Sciddie/voice-satelite/case/3mf/voicesat-weiss-diffusor-schablone.3mf

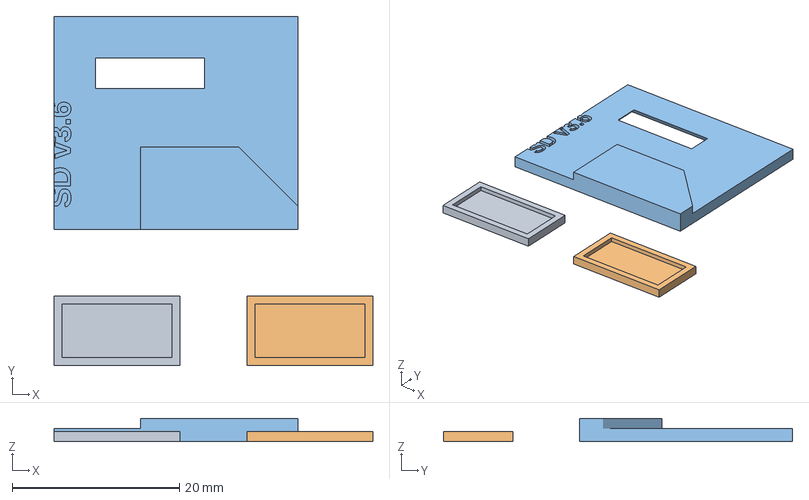
[picture p7: CAD file, 2026-10-12]
case/3mf/voicesat-weiss-diffusor-schablone.3mf
38.2 x 41.8 x 2.80 mm
led_diffuser_WHITE_1
led_diffuser_WHITE_2
sd_schablone_v36_WHITE
