Sciddie/voice-satelite/case/stl/lid.stl

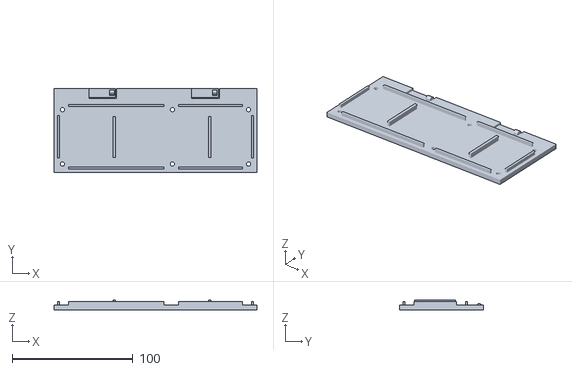
[picture p8: CAD file, 2026-10-12]
case/stl/lid.stl
168.0 x 69.5 x 8.00
