Sciddie/voice-satelite/case/3mf/voicesat-case-v3.7-black.3mf

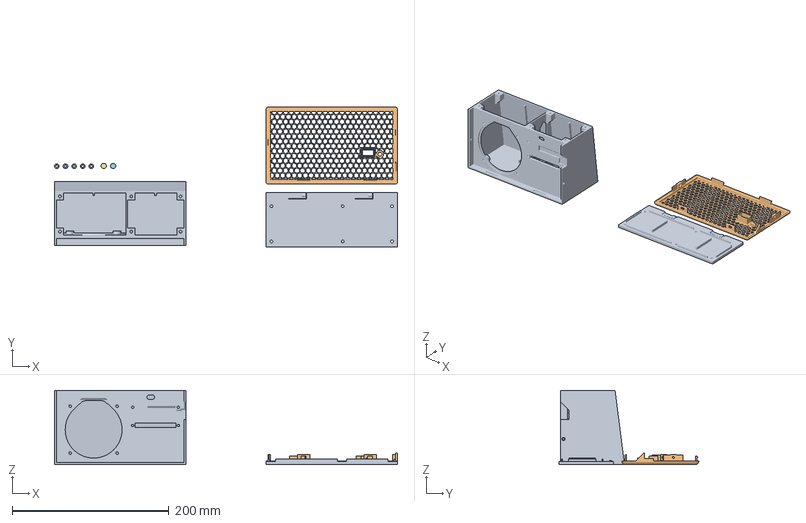
[picture p9: CAD file, 2026-10-12]
case/3mf/voicesat-case-v3.7-black.3mf
438.0 x 178.5 x 94.5 mm
tube_spacer_1
tube_spacer_2
tube_spacer_3
tube_spacer_4
tube_spacer_5
plunger_1
plunger_2
lid
grille
