Sciddie/voice-satelite/case/stl/body.stl

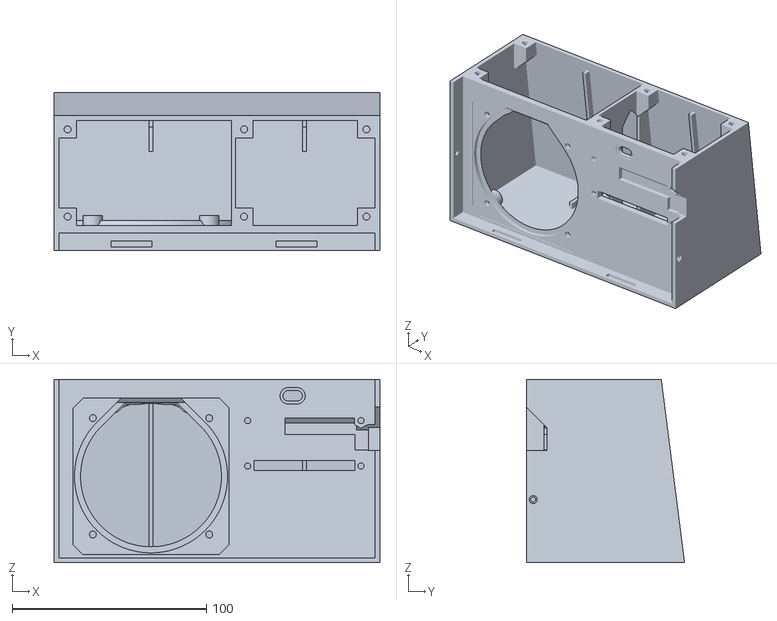
[picture p10: CAD file, 2026-10-12]
case/stl/body.stl
168.0 x 81.5 x 94.5
