Sciddie/voice-satelite/case/3mf/voicesat-case-v3.7-white.3mf

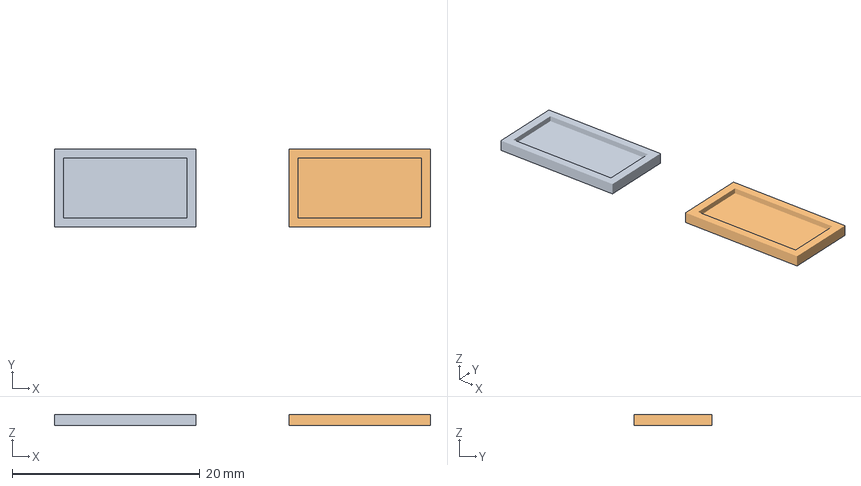
[picture p11: CAD file, 2026-10-12]
case/3mf/voicesat-case-v3.7-white.3mf
40.1 x 8.30 x 1.20 mm
led_diffuser_WHITE_1
led_diffuser_WHITE_2
