Sciddie/voice-satelite/case/stl/diffuser.stl

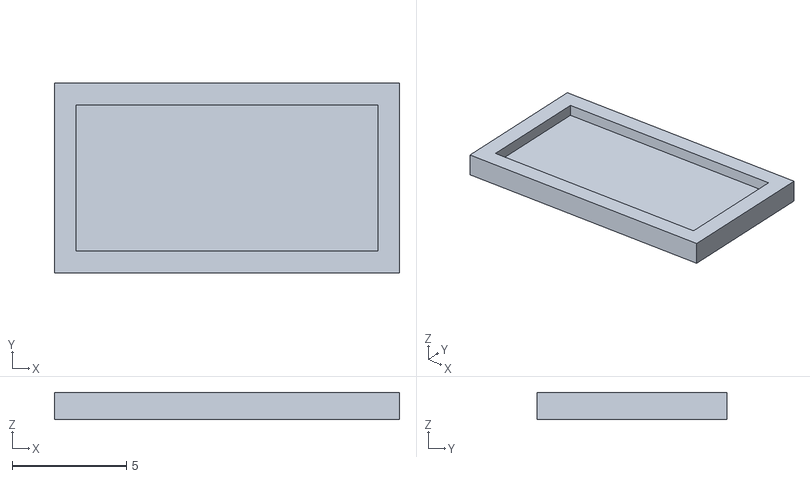
[picture p12: CAD file, 2026-10-12]
case/stl/diffuser.stl
15.1 x 8.30 x 1.20
