Sciddie/voice-satelite/case/3mf/voicesat-case-v3.7-black-plate2.3mf

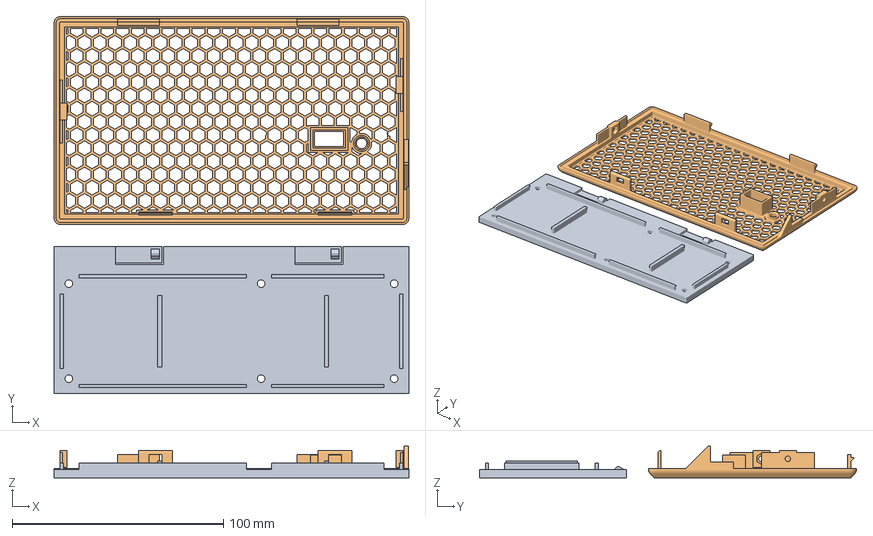
[picture p13: CAD file, 2026-10-12]
case/3mf/voicesat-case-v3.7-black-plate2.3mf
168.0 x 178.5 x 15.0 mm
lid
grille
