Sciddie/voice-satelite/case/stl/grille.stl

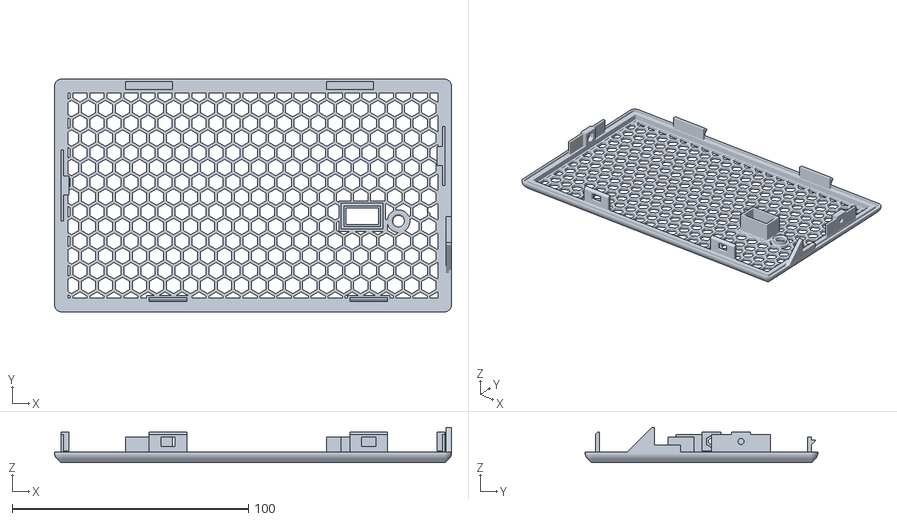
[picture p14: CAD file, 2026-10-12]
case/stl/grille.stl
168.0 x 98.5 x 15.0
