Sciddie/voice-satelite/case/stl/plunger.stl

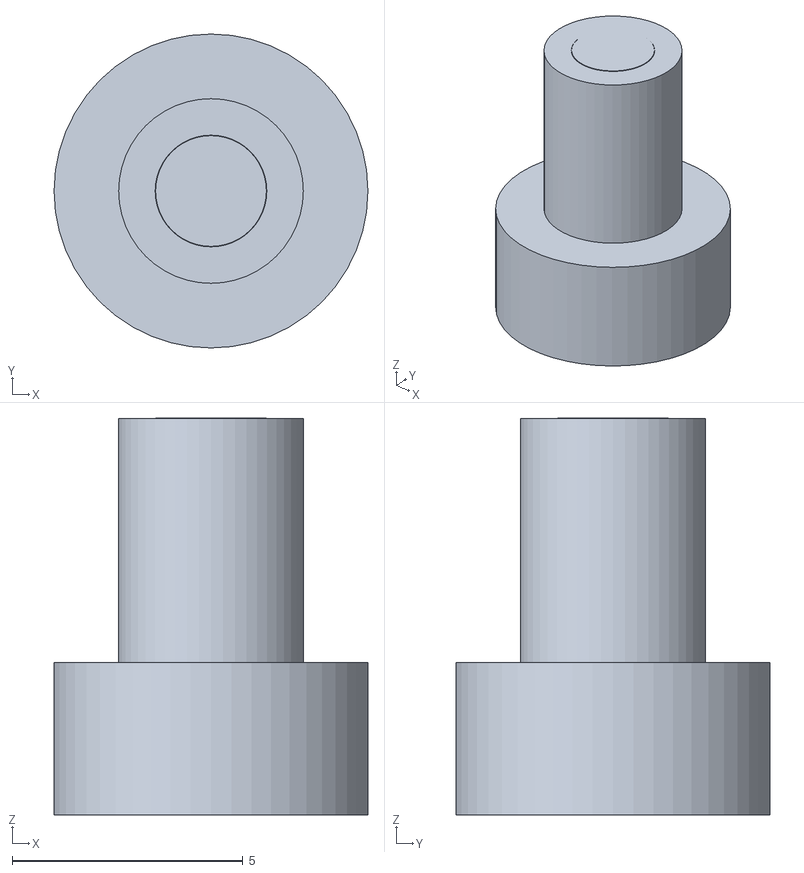
[picture p16: CAD file, 2026-10-12]
case/stl/plunger.stl
6.80 x 6.80 x 8.60
