Sciddie/voice-satelite/case/3mf/voicesat-sd-schablone.3mf

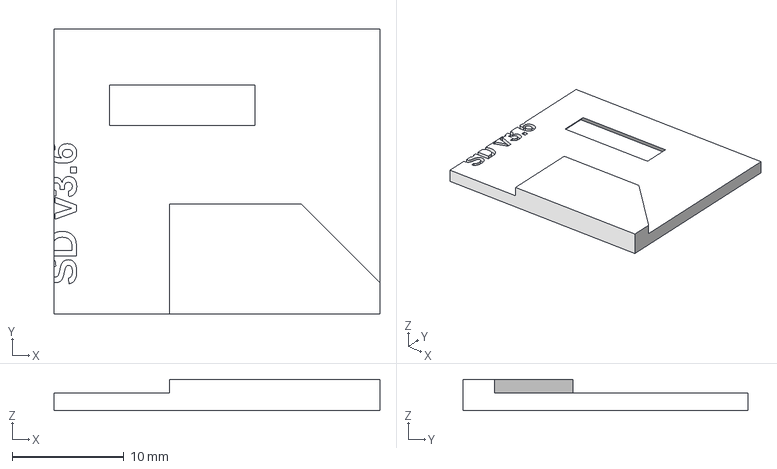
[picture p17: CAD file, 2026-10-12]
case/3mf/voicesat-sd-schablone.3mf
29.2 x 25.5 x 2.80 mm
