Sciddie/voice-satelite/case/stl/spacer.stl

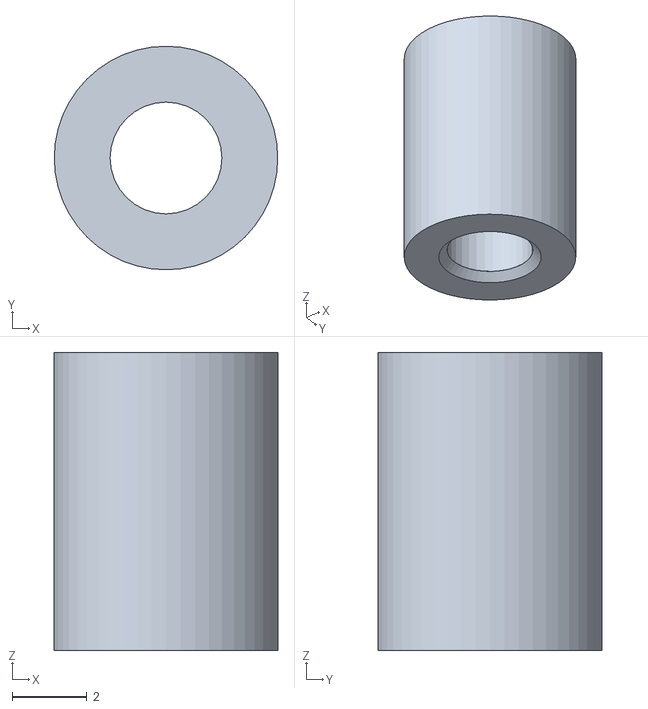
[picture p18: CAD file, 2026-10-12]
case/stl/spacer.stl
6.00 x 6.00 x 8.00
