Sciddie/voice-satelite/(list of files, cad)

Other CAD files:
case/stl/voicesat-sd-schablone.stl
