Sciddie/voice-satelite/mic-benchmark/live_metrics.csv

run | variant | sentences | wer | cer | word_errors | ref_words | sent_exact | speech_rms_dbfs | peak_dbfs | clip_samples | noise_floor_dbfs | snr_db | hf_ratio_pct | evo4_lag_s
live_base | avg | 9 | 0.5 | 0.4642 | 35 | 70 | 1/9 | -39.6213 | -17.818 | 0 | -64.9406 | 25.3065 | 4.64 | 0.0
live_base | L | 9 | 0.4429 | 0.2945 | 31 | 70 | 0/9 | -39.5539 | -17.2459 | 0 | -63.0089 | 23.4353 | 7.8193 | 0.0
live_base | R | 9 | 0.2143 | 0.1656 | 15 | 70 | 4/9 | -39.0246 | -16.6153 | 0 | -63.2565 | 24.2154 | 6.0301 | 0.0
live_base | evo4 | 9 | 0.3571 | 0.2454 | 25 | 70 | 3/9 | -46.457 | -23.8147 | 0 | -75.1185 | 28.6556 | 2.2106 | -1.8
live_base | avg+hp80norm | 9 | 0.2571 | 0.1779 | 18 | 70 | 2/9 | -22.8175 | -1.0 | 0 | -48.1794 | 25.3492 | 4.6628 | 0.0
live_base_b | avg | 10 | 0.1125 | 0.0516 | 9 | 80 | 4/10 | -39.6175 | -16.7523 | 0 | -64.9109 | 25.2805 | 4.4727 | 0.0
live_base_b | L | 10 | 0.05 | 0.0184 | 4 | 80 | 6/10 | -39.4416 | -16.8623 | 0 | -62.2406 | 22.7761 | 7.543 | 0.0
live_base_b | R | 10 | 0.0625 | 0.0221 | 5 | 80 | 7/10 | -39.0436 | -15.7819 | 0 | -63.3296 | 24.2698 | 5.6719 | 0.0
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
