Sciddie/voice-satelite/mic-benchmark/metrics.csv

variant | run | channel | fs | wer | cer | word_errors | ref_words | sent_exact | speech_rms_dbfs | peak_dbfs | clip_samples | noise_floor_dbfs | noise_floor_band_dbfs | snr_db | hf_ratio_pct | beep_dbfs | drift_ppm
alc_on|L | alc_on | L | 16000 | 0.1375 | 0.0479 | 11 | 80 | 6 | -26.2794 | -8.9126 | 0 | -41.4116 | -45.044 | 18.0395 | 5.8404 | -22.5975 | -247.9105
alc_on|R | alc_on | R | 16000 | 0.1 | 0.0295 | 8 | 80 | 5 | -25.6285 | -8.7186 | 0 | -42.6723 | -46.2409 | 19.9378 | 3.2574 | -22.0748 | -198.8409
alc_on|avg | alc_on | avg | 16000 | 0.0625 | 0.0147 | 5 | 80 | 6 | -26.1708 | -10.1539 | 0 | -43.6446 | -47.5826 | 20.7138 | 2.037 | -22.3336 | -485.3017
alc_on|evo4 | alc_on | evo4 | 48000 | 0.0875 | 0.0166 | 7 | 80 | 6 | -50.0629 | -33.179 | 0 | -64.3418 | -74.481 | 23.5027 | 2.1799 | -43.6181 | -272.6664
alc_on_b|L | alc_on_b | L | 16000 | 0.1375 | 0.046 | 11 | 80 | 6 | -26.2464 | -9.1205 | 0 | -41.3419 | -45.0229 | 18.0471 | 5.7521 | -22.4229 | -255.8678
alc_on_b|R | alc_on_b | R | 16000 | 0.0875 | 0.0295 | 7 | 80 | 7 | -25.5929 | -9.0181 | 0 | -42.5358 | -46.3453 | 20.0769 | 3.1936 | -21.8232 | -178.9478
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
