Sciddie/voice-satelite/mic-benchmark/metrics_per_sentence.csv

variant | run | channel | seg | rms_dbfs | peak_dbfs | snr_db | hf_ratio | wer | cer | hyp | ref
alc_on|L | alc_on | L | s01 | -25.3138 | -11.1798 | 18.9544 | 0.0283 | 0.0 | 0.0 | Schalte das Licht im Wohnzimmer auf 50%. | Schalte das Licht im Wohnzimmer auf fünfzig Prozent.
alc_on|L | alc_on | L | s02 | -25.672 | -11.179 | 19.2303 | 0.0376 | 0.0 | 0.0 | Wie warm ist es im Badezimmer? | Wie warm ist es im Badezimmer?
alc_on|L | alc_on | L | s03 | -25.2222 | -12.2723 | 18.2462 | 0.0069 | 0.0 | 0.0 | Stelle einen Timer auf 3 Minuten. | Stelle einen Timer auf drei Minuten.
alc_on|L | alc_on | L | s04 | -27.6908 | -12.9725 | 17.1294 | 0.0828 | 0.1429 | 0.0208 | Die 12-jährige übt Querflute in der Grünstraße. | Die Zwölfjährige übt Querflöte in der Grünstraße.
alc_on|L | alc_on | L | s05 | -25.9101 | -12.678 | 18.1721 | 0.017 | 0.7143 | 0.4348 | Das sind die 100 mit dem Schlafzimmer zur Hälfte. | Öffne die Rollläden im Schlafzimmer zur Hälfte.
alc_on|L | alc_on | L | s06 | -26.1392 | -8.9126 | 18.7494 | 0.3112 | 0.4 | 0.0274 | Fischer's Fritz fischt frische Fische, frische Fische fischt Fischer's Fritz. | Fischers Fritz fischt frische Fische, frische Fische fischt Fischers Fritz.
alc_on|L | alc_on | L | s07 | -26.2223 | -12.6915 | 18.0481 | 0.0175 | 0.2 | 0.04 | Die Donaudampfschifffahrtsgesellschaft prüft den Wärmepunktenwartungsvertrag. | Die Donaudampfschifffahrtsgesellschaft prüft den Wärmepumpenwartungsvertrag.
alc_on|L | alc_on | L | s08 | -27.6149 | -12.5184 | 17.2482 | 0.0496 | 0.0 | 0.0 | Setze die Heizung im Arbeitszimmer auf 21,5 Grad. | Setze die Heizung im Arbeitszimmer auf einundzwanzig Komma fünf Grad.
alc_on|L | alc_on | L | s09 | -26.6055 | -12.8392 | 16.9869 | 0.0112 | 0.0 | 0.0 | Der Raspberry Pi überträgt die Audio-Daten per WLAN an den Server. | Der Raspberry Pi überträgt die Audiodaten per WLAN an den Server.
alc_on|L | alc_on | L | s10 | -27.2211 | -13.9433 | 17.6299 | 0.022 | 0.0 | 0.0 | Erinnere mich morgen um 7.30 Uhr an den Müll. | Erinnere mich morgen um sieben Uhr dreißig an den Müll.
alc_on|R | alc_on | R | s01 | -24.6031 | -10.2117 | 20.9088 | 0.0145 | 0.0 | 0.0 | Schalte das Licht im Wohnzimmer auf 50%. | Schalte das Licht im Wohnzimmer auf fünfzig Prozent.
alc_on|R | alc_on | R | s02 | -24.8004 | -8.7186 | 21.3341 | 0.0182 | 0.1667 | 0.069 | Wie warm ist das im Badezimmer? | Wie warm ist es im Badezimmer?
alc_on|R | alc_on | R | s03 | -24.5096 | -11.2045 | 20.2218 | 0.0036 | 0.0 | 0.0 | Stelle einen Timer auf 3 Minuten. | Stelle einen Timer auf drei Minuten.
alc_on|R | alc_on | R | s04 | -27.1539 | -12.0631 | 18.9188 | 0.0436 | 0.1429 | 0.0208 | Die 12-jährige übt Querflute in der Grünstraße. | Die Zwölfjährige übt Querflöte in der Grünstraße.
alc_on|R | alc_on | R | s05 | -25.2405 | -11.9943 | 20.1037 | 0.008 | 0.1429 | 0.1739 | Öffne die Rundwerke im Schlafzimmer zur Hälfte. | Öffne die Rollläden im Schlafzimmer zur Hälfte.
alc_on|R | alc_on | R | s06 | -26.2527 | -10.3957 | 19.8627 | 0.191 | 0.4 | 0.0274 | Fischer's Fritz fischt frische Fische. Frische Fische fischt Fischer's Fritz. | Fischers Fritz fischt frische Fische, frische Fische fischt Fischers Fritz.
alc_on|R | alc_on | R | s07 | -25.6279 | -11.8912 | 19.8793 | 0.0083 | 0.2 | 0.04 | Die Donaudampfschifffahrtsgesellschaft prüft den Wärmepunktenwartungsvertrag. | Die Donaudampfschifffahrtsgesellschaft prüft den Wärmepumpenwartungsvertrag.
alc_on|R | alc_on | R | s08 | -26.671 | -11.885 | 19.4469 | 0.0223 | 0.0 | 0.0 | Setze die Heizung im Arbeitszimmer auf 21,5 Grad. | Setze die Heizung im Arbeitszimmer auf einundzwanzig Komma fünf Grad.
alc_on|R | alc_on | R | s09 | -25.9585 | -13.0612 | 18.9249 | 0.0053 | 0.0 | 0.0 | Der Raspberry Pi überträgt die Audio-Daten per WLAN an den Server. | Der Raspberry Pi überträgt die Audiodaten per WLAN an den Server.
alc_on|R | alc_on | R | s10 | -26.3195 | -12.4401 | 19.7767 | 0.0109 | 0.0 | 0.0 | Erinnere mich morgen um 7.30 Uhr an den Müll. | Erinnere mich morgen um sieben Uhr dreißig an den Müll.
alc_on|avg | alc_on | avg | s01 | -25.0828 | -10.6822 | 21.757 | 0.0085 | 0.0 | 0.0 | Schalte das Licht im Wohnzimmer auf 50%. | Schalte das Licht im Wohnzimmer auf fünfzig Prozent.
alc_on|avg | alc_on | avg | s02 | -25.4059 | -10.1539 | 22.0773 | 0.0106 | 0.0 | 0.0 | Wie warm ist es im Badezimmer? | Wie warm ist es im Badezimmer?
alc_on|avg | alc_on | avg | s03 | -24.9347 | -11.722 | 21.1078 | 0.0031 | 0.0 | 0.0 | Stelle einen Timer auf 3 Minuten. | Stelle einen Timer auf drei Minuten.
alc_on|avg | alc_on | avg | s04 | -27.728 | -12.9119 | 19.6985 | 0.0254 | 0.1429 | 0.0208 | Die 12-jährige übt Querflute in der Grünstraße. | Die Zwölfjährige übt Querflöte in der Grünstraße.
alc_on|avg | alc_on | avg | s05 | -25.6711 | -12.353 | 20.9958 | 0.0059 | 0.1429 | 0.0652 | Öffne die Ruhläden im Schlafzimmer zur Hälfte. | Öffne die Rollläden im Schlafzimmer zur Hälfte.
alc_on|avg | alc_on | avg | s06 | -27.166 | -11.2649 | 20.2938 | 0.1196 | 0.0 | 0.0 | Fischers Fritz fischt frische Fische, frische Fische fischt Fischers Fritz. | Fischers Fritz fischt frische Fische, frische Fische fischt Fischers Fritz.
alc_on|avg | alc_on | avg | s07 | -26.05 | -12.4444 | 20.7942 | 0.0061 | 0.2 | 0.04 | Die Donaudampfschifffahrtsgesellschaft prüft den Wärmepunktenwartungsvertrag. | Die Donaudampfschifffahrtsgesellschaft prüft den Wärmepumpenwartungsvertrag.
alc_on|avg | alc_on | avg | s08 | -27.3962 | -12.4001 | 20.0712 | 0.0132 | 0.0 | 0.0 | Setze die Heizung im Arbeitszimmer auf 21,5 Grad. | Setze die Heizung im Arbeitszimmer auf einundzwanzig Komma fünf Grad.
alc_on|avg | alc_on | avg | s09 | -26.3793 | -12.9495 | 19.8091 | 0.004 | 0.0 | 0.0 | Der Raspberry Pi überträgt die Audio-Daten per WLAN an den Server. | Der Raspberry Pi überträgt die Audiodaten per WLAN an den Server.
alc_on|avg | alc_on | avg | s10 | -26.9165 | -14.0763 | 20.5331 | 0.0074 | 0.2 | 0.0185 | Erinnere michЗMORGEN um 7.30 Uhr an den Müll. | Erinnere mich morgen um sieben Uhr dreißig an den Müll.
alc_on|evo4 | alc_on | evo4 | s01 | -49.1106 | -35.8516 | 24.173 | 0.0056 | 0.0 | 0.0 | Schalte das Licht im Wohnzimmer auf 50%. | Schalte das Licht im Wohnzimmer auf fünfzig Prozent.
alc_on|evo4 | alc_on | evo4 | s02 | -50.7385 | -36.9352 | 22.9334 | 0.0049 | 0.0 | 0.0 | Wie warm ist es im Badezimmer? | Wie warm ist es im Badezimmer?
alc_on|evo4 | alc_on | evo4 | s03 | -48.0531 | -33.179 | 25.1618 | 0.0008 | 0.0 | 0.0 | Stelle einen Timer auf 3 Minuten. | Stelle einen Timer auf drei Minuten.
alc_on|evo4 | alc_on | evo4 | s04 | -50.3081 | -36.5742 | 23.0971 | 0.017 | 0.1429 | 0.0208 | Die Zwölfjährige übt Querflute in der Grünstraße. | Die Zwölfjährige übt Querflöte in der Grünstraße.
alc_on|evo4 | alc_on | evo4 | s05 | -49.7787 | -36.4013 | 23.7717 | 0.0025 | 0.1429 | 0.0652 | Öffne die Rouladen im Schlafzimmer zur Hälfte. | Öffne die Rollläden im Schlafzimmer zur Hälfte.
alc_on|evo4 | alc_on | evo4 | s06 | -52.0049 | -35.5724 | 22.1845 | 0.1741 | 0.4 | 0.0274 | Fischer's Fritz fischt frische Fische, frische Fische fischt Fischer's Fritz. | Fischers Fritz fischt frische Fische, frische Fische fischt Fischers Fritz.
alc_on|evo4 | alc_on | evo4 | s07 | -50.241 | -35.5625 | 23.4112 | 0.0038 | 0.2 | 0.04 | Die Donaudampfschifffahrtsgesellschaft prüft den Wärmepunktenwartungsvertrag. | Die Donaudampfschifffahrtsgesellschaft prüft den Wärmepumpenwartungsvertrag.
alc_on|evo4 | alc_on | evo4 | s08 | -51.3738 | -34.9404 | 22.991 | 0.0052 | 0.0 | 0.0 | Setze die Heizung im Arbeitszimmer auf 21,5 Grad. | Setze die Heizung im Arbeitszimmer auf einundzwanzig Komma fünf Grad.
alc_on|evo4 | alc_on | evo4 | s09 | -50.2545 | -35.995 | 23.0334 | 0.0013 | 0.0 | 0.0 | Der Raspberry Pi überträgt die Audiodaten per WLAN an den Server. | Der Raspberry Pi überträgt die Audiodaten per WLAN an den Server.
alc_on|evo4 | alc_on | evo4 | s10 | -50.0541 | -36.0205 | 24.2698 | 0.0028 | 0.0 | 0.0 | Erinnere mich morgen um 7.30 Uhr an den Müll. | Erinnere mich morgen um sieben Uhr dreißig an den Müll.
alc_on_b|L | alc_on_b | L | s01 | -25.2855 | -11.2877 | 18.9697 | 0.027 | 0.0 | 0.0 | Schalte das Licht im Wohnzimmer auf 50%. | Schalte das Licht im Wohnzimmer auf fünfzig Prozent.
alc_on_b|L | alc_on_b | L | s02 | -25.6342 | -11.0405 | 19.2469 | 0.0368 | 0.0 | 0.0 | Wie warm ist es im Badezimmer? | Wie warm ist es im Badezimmer?
alc_on_b|L | alc_on_b | L | s03 | -25.1812 | -12.1655 | 18.2524 | 0.0059 | 0.0 | 0.0 | Stelle einen Timer auf 3 Minuten. | Stelle einen Timer auf drei Minuten.
alc_on_b|L | alc_on_b | L | s04 | -27.6431 | -13.5517 | 17.1696 | 0.0834 | 0.1429 | 0.0208 | Die 12-jährige übt Querflute in der Grünstraße. | Die Zwölfjährige übt Querflöte in der Grünstraße.
alc_on_b|L | alc_on_b | L | s05 | -25.8535 | -12.5223 | 18.2021 | 0.0157 | 0.7143 | 0.413 | Das wird die Ruhlein mit dem Schlafzimmer zur Hälfte. | Öffne die Rollläden im Schlafzimmer zur Hälfte.
alc_on_b|L | alc_on_b | L | s06 | -26.1234 | -9.1205 | 18.7484 | 0.3092 | 0.4 | 0.0274 | Fischer's Fritz fischt frische Fische. Frische Fische fischt Fischer's Fritz. | Fischers Fritz fischt frische Fische, frische Fische fischt Fischers Fritz.
alc_on_b|L | alc_on_b | L | s07 | -26.1812 | -12.7485 | 18.0568 | 0.0171 | 0.2 | 0.04 | Die Donaudampfschifffahrtsgesellschaft prüft den Wärmepunktenwartungsvertrag. | Die Donaudampfschifffahrtsgesellschaft prüft den Wärmepumpenwartungsvertrag.
alc_on_b|L | alc_on_b | L | s08 | -27.6088 | -12.5472 | 17.2275 | 0.0491 | 0.0 | 0.0 | Setze die Heizung im Arbeitszimmer auf 21,5 Grad. | Setze die Heizung im Arbeitszimmer auf einundzwanzig Komma fünf Grad.
alc_on_b|L | alc_on_b | L | s09 | -26.5761 | -12.7309 | 16.9724 | 0.011 | 0.0 | 0.0 | Der Raspberry Pi überträgt die Audio-Daten per WLAN an den Server. | Der Raspberry Pi überträgt die Audiodaten per WLAN an den Server.
alc_on_b|L | alc_on_b | L | s10 | -27.206 | -13.8583 | 17.6256 | 0.02 | 0.0 | 0.0 | Erinnere mich morgen um 7.30 Uhr an den Müll. | Erinnere mich morgen um sieben Uhr dreißig an den Müll.
alc_on_b|R | alc_on_b | R | s01 | -24.5717 | -9.902 | 21.0403 | 0.0143 | 0.0 | 0.0 | Schalte das Licht im Wohnzimmer auf 50%. | Schalte das Licht im Wohnzimmer auf fünfzig Prozent.
alc_on_b|R | alc_on_b | R | s02 | -24.7403 | -9.0181 | 21.5057 | 0.0177 | 0.0 | 0.0 | Wie warm ist es im Badezimmer? | Wie warm ist es im Badezimmer?
alc_on_b|R | alc_on_b | R | s03 | -24.4662 | -10.7378 | 20.3638 | 0.0034 | 0.0 | 0.0 | Stelle einen Timer auf 3 Minuten. | Stelle einen Timer auf drei Minuten.
alc_on_b|R | alc_on_b | R | s04 | -27.146 | -11.5513 | 19.0457 | 0.042 | 0.1429 | 0.0208 | Die 12-Jährige übt Querflute in der Grünstraße. | Die Zwölfjährige übt Querflöte in der Grünstraße.
alc_on_b|R | alc_on_b | R | s05 | -25.217 | -11.8542 | 20.231 | 0.0075 | 0.0 | 0.0 | Öffne die Rollläden im Schlafzimmer zur Hälfte. | Öffne die Rollläden im Schlafzimmer zur Hälfte.
alc_on_b|R | alc_on_b | R | s06 | -26.2352 | -10.3336 | 19.9775 | 0.1889 | 0.4 | 0.0822 | Fischer Spritz fischt frische Fische, frische Fische fischt Fischer Spritz. | Fischers Fritz fischt frische Fische, frische Fische fischt Fischers Fritz.
alc_on_b|R | alc_on_b | R | s07 | -25.5584 | -11.9592 | 20.0608 | 0.008 | 0.4 | 0.12 | Die Donaudampfschifffahrtsgesellschaft prüりました den Werbepunktenwartungsvertrag. | Die Donaudampfschifffahrtsgesellschaft prüft den Wärmepumpenwartungsvertrag.
alc_on_b|R | alc_on_b | R | s08 | -26.6579 | -12.0271 | 19.5578 | 0.0223 | 0.0 | 0.0 | Setze die Heizung im Arbeitszimmer auf 21,5 Grad. | Setze die Heizung im Arbeitszimmer auf einundzwanzig Komma fünf Grad.
alc_on_b|R | alc_on_b | R | s09 | -25.9187 | -12.3276 | 19.0617 | 0.0054 | 0.0 | 0.0 | Der Raspberry Pi überträgt die Audio-Daten per WLAN an den Server. | Der Raspberry Pi überträgt die Audiodaten per WLAN an den Server.
alc_on_b|R | alc_on_b | R | s10 | -26.2915 | -12.6377 | 19.9246 | 0.0098 | 0.0 | 0.0 | Erinnere mich morgen um 7.30 Uhr an den Müll. | Erinnere mich morgen um sieben Uhr dreißig an den Müll.
alc_on_b|avg | alc_on_b | avg | s01 | -25.0498 | -10.636 | 21.9592 | 0.008 | 0.0 | 0.0 | Schalte das Licht im Wohnzimmer auf 50%. | Schalte das Licht im Wohnzimmer auf fünfzig Prozent.
alc_on_b|avg | alc_on_b | avg | s02 | -25.3566 | -10.4324 | 22.3009 | 0.0097 | 0.0 | 0.0 | Wie warm ist es im Badezimmer? | Wie warm ist es im Badezimmer?
alc_on_b|avg | alc_on_b | avg | s03 | -24.8936 | -11.4223 | 21.3081 | 0.0026 | 0.0 | 0.0 | Stelle einen Timer auf 3 Minuten. | Stelle einen Timer auf drei Minuten.
alc_on_b|avg | alc_on_b | avg | s04 | -27.698 | -12.8095 | 19.9104 | 0.0238 | 0.1429 | 0.0208 | Die 12-Jährige übt Querflute in der Grünstraße. | Die Zwölfjährige übt Querflöte in der Grünstraße.
alc_on_b|avg | alc_on_b | avg | s05 | -25.6292 | -12.1893 | 21.2039 | 0.0052 | 0.0 | 0.0 | Öffne die Rollläden im Schlafzimmer zur Hälfte. | Öffne die Rollläden im Schlafzimmer zur Hälfte.
alc_on_b|avg | alc_on_b | avg | s06 | -27.1451 | -11.4614 | 20.4811 | 0.1178 | 0.0 | 0.0 | Fischers Fritz fischt frische Fische, frische Fische fischt Fischers Fritz. | Fischers Fritz fischt frische Fische, frische Fische fischt Fischers Fritz.
alc_on_b|avg | alc_on_b | avg | s07 | -25.9905 | -12.4504 | 21.0207 | 0.0056 | 0.2 | 0.0667 | Die Donaudampfschifffahrtsgesellschaft prüft den Werbepunktenwartungsvertrag. | Die Donaudampfschifffahrtsgesellschaft prüft den Wärmepumpenwartungsvertrag.
alc_on_b|avg | alc_on_b | avg | s08 | -27.3871 | -12.4654 | 20.2452 | 0.0132 | 0.0 | 0.0 | Setze die Heizung im Arbeitszimmer auf 21,5 Grad. | Setze die Heizung im Arbeitszimmer auf einundzwanzig Komma fünf Grad.
alc_on_b|avg | alc_on_b | avg | s09 | -26.3445 | -12.6114 | 19.9991 | 0.0041 | 0.0 | 0.0 | Der Raspberry Pi überträgt die Audio-Daten per WLAN an den Server. | Der Raspberry Pi überträgt die Audiodaten per WLAN an den Server.
alc_on_b|avg | alc_on_b | avg | s10 | -26.8945 | -14.2283 | 20.7339 | 0.0061 | 0.0 | 0.0 | Erinnere mich morgen um 7.30 Uhr an den Müll. | Erinnere mich morgen um sieben Uhr dreißig an den Müll.
alc_on_b|evo4 | alc_on_b | evo4 | s01 | -49.0762 | -34.983 | 23.6465 | 0.0056 | 0.0 | 0.0 | Schalte das Licht im Wohnzimmer auf 50%. | Schalte das Licht im Wohnzimmer auf fünfzig Prozent.
alc_on_b|evo4 | alc_on_b | evo4 | s02 | -51.4131 | -37.1706 | 22.3864 | 0.0049 | 0.0 | 0.0 | Wie warm ist es im Badezimmer? | Wie warm ist es im Badezimmer?
alc_on_b|evo4 | alc_on_b | evo4 | s03 | -48.0092 | -33.031 | 24.6406 | 0.0008 | 0.0 | 0.0 | Stelle einen Timer auf 3 Minuten. | Stelle einen Timer auf drei Minuten.
alc_on_b|evo4 | alc_on_b | evo4 | s04 | -51.0346 | -36.8958 | 22.5793 | 0.0169 | 0.1429 | 0.0208 | Die 12-Jährige übt Querflute in der Grünstraße. | Die Zwölfjährige übt Querflöte in der Grünstraße.
alc_on_b|evo4 | alc_on_b | evo4 | s05 | -49.5379 | -36.132 | 23.2685 | 0.0026 | 0.1429 | 0.1304 | Öffne die Rundern im Schlafzimmer zur Hälfte. | Öffne die Rollläden im Schlafzimmer zur Hälfte.
alc_on_b|evo4 | alc_on_b | evo4 | s06 | -51.7664 | -35.9269 | 21.6644 | 0.1746 | 0.0 | 0.0 | Fischers Fritz fischt frische Fische, frische Fische fischt Fischers Fritz. | Fischers Fritz fischt frische Fische, frische Fische fischt Fischers Fritz.
alc_on_b|evo4 | alc_on_b | evo4 | s07 | -50.2002 | -35.5491 | 22.8927 | 0.0038 | 0.2 | 0.04 | Die Donaudampfschifffahrtsgesellschaft prüft den Wärmepunktenwartungsvertrag. | Die Donaudampfschifffahrtsgesellschaft prüft den Wärmepumpenwartungsvertrag.
alc_on_b|evo4 | alc_on_b | evo4 | s08 | -51.1693 | -34.6118 | 22.4683 | 0.0052 | 0.0 | 0.0 | Setze die Heizung im Arbeitszimmer auf 21,5 Grad. | Setze die Heizung im Arbeitszimmer auf einundzwanzig Komma fünf Grad.
alc_on_b|evo4 | alc_on_b | evo4 | s09 | -50.2146 | -35.5336 | 22.5218 | 0.0013 | 0.0 | 0.0 | Der Raspberry Pi überträgt die Audiodaten per WLAN an den Server. | Der Raspberry Pi überträgt die Audiodaten per WLAN an den Server.
alc_on_b|evo4 | alc_on_b | evo4 | s10 | -50.0949 | -36.0238 | 23.7402 | 0.0028 | 0.0 | 0.0 | Erinnere mich morgen um 7.30 Uhr an den Müll. | Erinnere mich morgen um sieben Uhr dreißig an den Müll.
alc_on_c|L | alc_on_c | L | s01 | -25.5743 | -11.5049 | 18.1768 | 0.0284 | 0.0 | 0.0 | Schalte das Licht im Wohnzimmer auf 50 Prozent. | Schalte das Licht im Wohnzimmer auf fünfzig Prozent.
alc_on_c|L | alc_on_c | L | s02 | -25.7936 | -10.3383 | 18.7199 | 0.0389 | 0.0 | 0.0 | Wie warm ist es im Badezimmer? | Wie warm ist es im Badezimmer?
alc_on_c|L | alc_on_c | L | s03 | -25.4339 | -12.4485 | 17.331 | 0.0063 | 0.0 | 0.0 | Stelle einen Timer auf 3 Minuten. | Stelle einen Timer auf drei Minuten.
alc_on_c|L | alc_on_c | L | s04 | -27.111 | -11.0279 | 16.8176 | 0.0788 | 0.1429 | 0.0208 | Die 12-Jährige übt Querflute in der Grünstraße. | Die Zwölfjährige übt Querflöte in der Grünstraße.
alc_on_c|L | alc_on_c | L | s05 | -25.8435 | -12.2486 | 17.8493 | 0.0162 | 0.4286 | 0.2609 | Das sind die Rundleiden im Schlafzimmer zur Hälfte. | Öffne die Rollläden im Schlafzimmer zur Hälfte.
alc_on_c|L | alc_on_c | L | s06 | -26.11 | -9.8149 | 18.3883 | 0.3137 | 0.4 | 0.0274 | Fischer's Fritz fischt frische Fische, frische Fische fischt Fischer's Fritz. | Fischers Fritz fischt frische Fische, frische Fische fischt Fischers Fritz.
alc_on_c|L | alc_on_c | L | s07 | -26.1483 | -12.9664 | 17.7146 | 0.0169 | 0.2 | 0.04 | Die Donaudampfschifffahrtsgesellschaft prüft den Wärmefundenwartungsvertrag. | Die Donaudampfschifffahrtsgesellschaft prüft den Wärmepumpenwartungsvertrag.
alc_on_c|L | alc_on_c | L | s08 | -27.6094 | -12.1885 | 16.8555 | 0.049 | 0.0 | 0.0 | Setze die Heizung im Arbeitszimmer auf 21,5 Grad. | Setze die Heizung im Arbeitszimmer auf einundzwanzig Komma fünf Grad.
alc_on_c|L | alc_on_c | L | s09 | -26.5507 | -13.135 | 16.6157 | 0.0106 | 0.0 | 0.0 | Der Raspberry Pi überträgt die Audio-Daten per WLAN an den Server. | Der Raspberry Pi überträgt die Audiodaten per WLAN an den Server.
alc_on_c|L | alc_on_c | L | s10 | -27.1963 | -13.7905 | 17.263 | 0.0209 | 0.0 | 0.0 | Erinnere mich morgen um 7.30 Uhr an den Müll. | Erinnere mich morgen um sieben Uhr dreißig an den Müll.
alc_on_c|R | alc_on_c | R | s01 | -25.0187 | -10.8821 | 20.2231 | 0.0151 | 0.0 | 0.0 | Schalte das Licht im Wohnzimmer auf 50 Prozent. | Schalte das Licht im Wohnzimmer auf fünfzig Prozent.
alc_on_c|R | alc_on_c | R | s02 | -24.8462 | -9.9187 | 21.1344 | 0.0182 | 0.1667 | 0.069 | Wie warm ist das im Badezimmer? | Wie warm ist es im Badezimmer?
alc_on_c|R | alc_on_c | R | s03 | -24.768 | -11.0319 | 19.568 | 0.0036 | 0.0 | 0.0 | Stelle einen Timer auf 3 Minuten. | Stelle einen Timer auf drei Minuten.
alc_on_c|R | alc_on_c | R | s04 | -26.6202 | -10.0241 | 18.8358 | 0.0419 | 0.1429 | 0.0208 | Die 12-Jährige übt Querflute in der Grünstraße. | Die Zwölfjährige übt Querflöte in der Grünstraße.
alc_on_c|R | alc_on_c | R | s05 | -25.1809 | -11.6925 | 20.0017 | 0.0072 | 0.1429 | 0.087 | Öffne die Roller im Schlafzimmer zur Hälfte. | Öffne die Rollläden im Schlafzimmer zur Hälfte.
alc_on_c|R | alc_on_c | R | s06 | -26.2505 | -10.0797 | 19.6993 | 0.1897 | 0.4 | 0.0274 | Fischer's Fritz fischt frische Fische. Frische Fische fischt Fischer's Fritz. | Fischers Fritz fischt frische Fische, frische Fische fischt Fischers Fritz.
alc_on_c|R | alc_on_c | R | s07 | -25.5699 | -11.3784 | 19.7771 | 0.008 | 0.2 | 0.04 | Die Donaudampfschifffahrtsgesellschaft prüft den Wärmepunktenwartungsvertrag. | Die Donaudampfschifffahrtsgesellschaft prüft den Wärmepumpenwartungsvertrag.
alc_on_c|R | alc_on_c | R | s08 | -26.6583 | -12.2011 | 19.2953 | 0.0219 | 0.0 | 0.0 | Setze die Heizung im Arbeitszimmer auf 21,5 Grad. | Setze die Heizung im Arbeitszimmer auf einundzwanzig Komma fünf Grad.
alc_on_c|R | alc_on_c | R | s09 | -25.9428 | -12.7886 | 18.7756 | 0.0054 | 0.0 | 0.0 | Der Raspberry Pi überträgt die Audio-Daten per WLAN an den Server. | Der Raspberry Pi überträgt die Audiodaten per WLAN an den Server.
alc_on_c|R | alc_on_c | R | s10 | -26.2621 | -12.6216 | 19.6803 | 0.0102 | 0.0 | 0.0 | Erinnere mich morgen um 7.30 Uhr an den Müll. | Erinnere mich morgen um sieben Uhr dreißig an den Müll.
alc_on_c|avg | alc_on_c | avg | s01 | -25.4309 | -11.1879 | 21.0589 | 0.0083 | 0.0 | 0.0 | Schalte das Licht im Wohnzimmer auf 50%. | Schalte das Licht im Wohnzimmer auf fünfzig Prozent.
alc_on_c|avg | alc_on_c | avg | s02 | -25.4891 | -10.4492 | 21.7725 | 0.0104 | 0.1667 | 0.069 | Wie warm ist das im Badezimmer? | Wie warm ist es im Badezimmer?
alc_on_c|avg | alc_on_c | avg | s03 | -25.1694 | -11.7113 | 20.3711 | 0.0028 | 0.0 | 0.0 | Stelle einen Timer auf 3 Minuten. | Stelle einen Timer auf drei Minuten.
alc_on_c|avg | alc_on_c | avg | s04 | -27.1435 | -10.7595 | 19.5403 | 0.0225 | 0.1429 | 0.0208 | Die 12-jährige übt Querflute in der Grünstraße. | Die Zwölfjährige übt Querflöte in der Grünstraße.
alc_on_c|avg | alc_on_c | avg | s05 | -25.6061 | -12.1178 | 20.8334 | 0.0052 | 0.1429 | 0.1087 | Öffne die Ruhleiten im Schlafzimmer zur Hälfte. | Öffne die Rollläden im Schlafzimmer zur Hälfte.
alc_on_c|avg | alc_on_c | avg | s06 | -27.1555 | -11.5432 | 20.0697 | 0.118 | 0.4 | 0.0274 | Fischer's Fritz fischt frische Fische. Frische Fische fischt Fischer's Fritz. | Fischers Fritz fischt frische Fische, frische Fische fischt Fischers Fritz.
alc_on_c|avg | alc_on_c | avg | s07 | -25.9839 | -12.2142 | 20.6231 | 0.0056 | 0.2 | 0.04 | Die Donaudampfschifffahrtsgesellschaft prüft den Wärmepunktenwartungsvertrag. | Die Donaudampfschifffahrtsgesellschaft prüft den Wärmepumpenwartungsvertrag.
alc_on_c|avg | alc_on_c | avg | s08 | -27.3868 | -12.2968 | 19.8475 | 0.0132 | 0.0 | 0.0 | Setze die Heizung im Arbeitszimmer auf 21,5 Grad. | Setze die Heizung im Arbeitszimmer auf einundzwanzig Komma fünf Grad.
alc_on_c|avg | alc_on_c | avg | s09 | -26.3451 | -13.1689 | 19.5967 | 0.004 | 0.0 | 0.0 | Der Raspberry Pi überträgt die Audio-Daten per WLAN an den Server. | Der Raspberry Pi überträgt die Audiodaten per WLAN an den Server.
alc_on_c|avg | alc_on_c | avg | s10 | -26.8742 | -13.9973 | 20.3503 | 0.0066 | 0.0 | 0.0 | Erinnere mich morgen um 7.30 Uhr an den Müll. | Erinnere mich morgen um sieben Uhr dreißig an den Müll.
alc_on_c|evo4 | alc_on_c | evo4 | s01 | -50.3025 | -36.5346 | 22.9435 | 0.0074 | 0.0 | 0.0 | Schalte das Licht im Wohnzimmer auf 50%. | Schalte das Licht im Wohnzimmer auf fünfzig Prozent.
alc_on_c|evo4 | alc_on_c | evo4 | s02 | -50.235 | -35.5236 | 23.5237 | 0.0041 | 0.0 | 0.0 | Wie warm ist es im Badezimmer? | Wie warm ist es im Badezimmer?
alc_on_c|evo4 | alc_on_c | evo4 | s03 | -48.4511 | -33.415 | 24.5011 | 0.001 | 0.0 | 0.0 | Stelle einen Timer auf 3 Minuten. | Stelle einen Timer auf drei Minuten.
alc_on_c|evo4 | alc_on_c | evo4 | s04 | -50.928 | -37.0558 | 23.0601 | 0.0166 | 0.1429 | 0.0208 | Die 12-jährige übt Querflute in der Grünstraße. | Die Zwölfjährige übt Querflöte in der Grünstraße.
alc_on_c|evo4 | alc_on_c | evo4 | s05 | -49.7461 | -36.2627 | 23.6093 | 0.0026 | 0.1429 | 0.0435 | Öffne die Rollerden im Schlafzimmer zur Hälfte. | Öffne die Rollläden im Schlafzimmer zur Hälfte.
alc_on_c|evo4 | alc_on_c | evo4 | s06 | -51.5496 | -35.8578 | 21.9934 | 0.1778 | 0.4 | 0.0274 | Fischer's Fritz fischt frische Fische, frische Fische fischt Fischer's Fritz. | Fischers Fritz fischt frische Fische, frische Fische fischt Fischers Fritz.
alc_on_c|evo4 | alc_on_c | evo4 | s07 | -50.0259 | -35.9273 | 23.246 | 0.0038 | 0.2 | 0.04 | Die Donaudampfschifffahrtsgesellschaft prüft den Wärmepunktenwartungsvertrag. | Die Donaudampfschifffahrtsgesellschaft prüft den Wärmepumpenwartungsvertrag.
alc_on_c|evo4 | alc_on_c | evo4 | s08 | -51.1946 | -35.0709 | 22.7975 | 0.0053 | 0.0 | 0.0 | Setze die Heizung im Arbeitszimmer auf 21,5 Grad. | Setze die Heizung im Arbeitszimmer auf einundzwanzig Komma fünf Grad.
alc_on_c|evo4 | alc_on_c | evo4 | s09 | -48.4869 | -34.8075 | 22.8684 | 0.0013 | 0.0 | 0.0 | Der Raspberry Pi überträgt die Audiodaten per WLAN an den Server. | Der Raspberry Pi überträgt die Audiodaten per WLAN an den Server.
alc_on_c|evo4 | alc_on_c | evo4 | s10 | -50.0135 | -36.1996 | 24.0751 | 0.0028 | 0.0 | 0.0 | Erinnere mich morgen um 7.30 Uhr an den Müll. | Erinnere mich morgen um sieben Uhr dreißig an den Müll.
base16_a|L | base16_a | L | s01 | -41.6123 | -27.9398 | 18.6531 | 0.0271 | 0.0 | 0.0 | Schalte das Licht im Wohnzimmer auf 50 Prozent. | Schalte das Licht im Wohnzimmer auf fünfzig Prozent.
base16_a|L | base16_a | L | s02 | -41.9817 | -27.4952 | 18.9248 | 0.0383 | 0.0 | 0.0 | Wie warm ist es im Badezimmer? | Wie warm ist es im Badezimmer?
base16_a|L | base16_a | L | s03 | -41.4585 | -28.2838 | 17.9905 | 0.0069 | 0.0 | 0.0 | Stelle einen Timer auf 3 Minuten. | Stelle einen Timer auf drei Minuten.
base16_a|L | base16_a | L | s04 | -43.9069 | -29.7817 | 16.9089 | 0.0841 | 0.1429 | 0.0208 | Die 12-jährige übt Querflute in der Grünstraße. | Die Zwölfjährige übt Querflöte in der Grünstraße.
base16_a|L | base16_a | L | s05 | -42.1576 | -28.2632 | 17.9248 | 0.0171 | 0.4286 | 0.2826 | Das sind die Wunderden im Schlafzimmer zur Hälfte. | Öffne die Rollläden im Schlafzimmer zur Hälfte.
base16_a|L | base16_a | L | s06 | -42.4537 | -24.9871 | 18.4389 | 0.3108 | 0.4 | 0.0274 | Fischer's Fritz fischt frische Fische. Frische Fische fischt Fischer's Fritz. | Fischers Fritz fischt frische Fische, frische Fische fischt Fischers Fritz.
base16_a|L | base16_a | L | s07 | -42.5154 | -28.817 | 17.7476 | 0.0185 | 0.2 | 0.04 | Die Donaudampfschifffahrtsgesellschaft prüft den Wärmepunktenwartungsvertrag. | Die Donaudampfschifffahrtsgesellschaft prüft den Wärmepumpenwartungsvertrag.
base16_a|L | base16_a | L | s08 | -43.883 | -28.5363 | 16.9716 | 0.048 | 0.0 | 0.0 | Setze die Heizung im Arbeitszimmer auf 21,5 Grad. | Setze die Heizung im Arbeitszimmer auf einundzwanzig Komma fünf Grad.
base16_a|L | base16_a | L | s09 | -42.8379 | -28.6204 | 16.7365 | 0.0114 | 0.0 | 0.0 | Der Raspberry Pi überträgt die Audio-Daten per WLAN an den Server. | Der Raspberry Pi überträgt die Audiodaten per WLAN an den Server.
base16_a|L | base16_a | L | s10 | -43.4688 | -29.9468 | 17.373 | 0.0221 | 0.0 | 0.0 | Erinnere mich morgen um 7.30 Uhr an den Müll. | Erinnere mich morgen um sieben Uhr dreißig an den Müll.
base16_a|R | base16_a | R | s01 | -40.8644 | -26.3985 | 20.4852 | 0.0143 | 0.0 | 0.0 | Schalte das Licht im Wohnzimmer auf 50%. | Schalte das Licht im Wohnzimmer auf fünfzig Prozent.
base16_a|R | base16_a | R | s02 | -41.0776 | -25.3282 | 20.9109 | 0.0177 | 0.1667 | 0.069 | Wie warm ist das im Badezimmer? | Wie warm ist es im Badezimmer?
base16_a|R | base16_a | R | s03 | -40.7355 | -27.5344 | 19.8339 | 0.0037 | 0.0 | 0.0 | Stelle einen Timer auf 3 Minuten. | Stelle einen Timer auf drei Minuten.
base16_a|R | base16_a | R | s04 | -43.3902 | -28.1016 | 18.5339 | 0.0428 | 0.1429 | 0.0208 | Die 12-jährige übt Querflute in der Grünstraße. | Die Zwölfjährige übt Querflöte in der Grünstraße.
base16_a|R | base16_a | R | s05 | -41.4836 | -27.9745 | 19.7033 | 0.0079 | 0.4286 | 0.1739 | Öffne die Roller mit dem Schlafzimmer zur Hälfte. | Öffne die Rollläden im Schlafzimmer zur Hälfte.
base16_a|R | base16_a | R | s06 | -42.5029 | -26.4485 | 19.4589 | 0.1905 | 0.4 | 0.0274 | Fischer's Fritz fischt frische Fische. Frische Fische fischt Fischer's Fritz. | Fischers Fritz fischt frische Fische, frische Fische fischt Fischers Fritz.
base16_a|R | base16_a | R | s07 | -41.8866 | -27.9725 | 19.4675 | 0.0085 | 0.2 | 0.04 | Die Donaudampfschifffahrtsgesellschaft prüft den Wärmepunktenwartungsvertrag. | Die Donaudampfschifffahrtsgesellschaft prüft den Wärmepumpenwartungsvertrag.
base16_a|R | base16_a | R | s08 | -42.8982 | -27.8539 | 19.0556 | 0.022 | 0.0 | 0.0 | Setze die Heizung im Arbeitszimmer auf 21,5 Grad. | Setze die Heizung im Arbeitszimmer auf einundzwanzig Komma fünf Grad.
base16_a|R | base16_a | R | s09 | -42.227 | -29.0751 | 18.5195 | 0.0056 | 0.0 | 0.0 | Der Raspberry Pi überträgt die Audio-Daten per WLAN an den Server. | Der Raspberry Pi überträgt die Audiodaten per WLAN an den Server.
base16_a|R | base16_a | R | s10 | -42.5359 | -29.1075 | 19.3979 | 0.0109 | 0.0 | 0.0 | Erinnere mich morgen um 7.30 Uhr an den Müll. | Erinnere mich morgen um sieben Uhr dreißig an den Müll.
base16_a|avg | base16_a | avg | s01 | -41.3733 | -27.2508 | 21.378 | 0.0079 | 0.0 | 0.0 | Schalte das Licht im Wohnzimmer auf 50%. | Schalte das Licht im Wohnzimmer auf fünfzig Prozent.
base16_a|avg | base16_a | avg | s02 | -41.7078 | -26.6752 | 21.6953 | 0.0102 | 0.0 | 0.0 | Wie warm ist es im Badezimmer? | Wie warm ist es im Badezimmer?
base16_a|avg | base16_a | avg | s03 | -41.1799 | -28.1413 | 20.7697 | 0.0031 | 0.0 | 0.0 | Stelle einen Timer auf 3 Minuten. | Stelle einen Timer auf drei Minuten.
base16_a|avg | base16_a | avg | s04 | -43.9694 | -29.118 | 19.3814 | 0.0253 | 0.1429 | 0.0208 | Die 12-jährige übt Querflute in der Grünstraße. | Die Zwölfjährige übt Querflöte in der Grünstraße.
base16_a|avg | base16_a | avg | s05 | -41.9313 | -28.2708 | 20.6502 | 0.006 | 0.1429 | 0.1739 | Öffne die Runderung im Schlafzimmer zur Hälfte. | Öffne die Rollläden im Schlafzimmer zur Hälfte.
base16_a|avg | base16_a | avg | s06 | -43.4574 | -27.4485 | 19.9166 | 0.1181 | 0.4 | 0.0274 | Fischer's Fritz fischt frische Fische. Frische Fische fischt Fischer's Fritz. | Fischers Fritz fischt frische Fische, frische Fische fischt Fischers Fritz.
base16_a|avg | base16_a | avg | s07 | -42.3345 | -28.5354 | 20.4223 | 0.0065 | 0.2 | 0.04 | Die Donaudampfschifffahrtsgesellschaft prüft den Wärmepunktenwartungsvertrag. | Die Donaudampfschifffahrtsgesellschaft prüft den Wärmepumpenwartungsvertrag.
base16_a|avg | base16_a | avg | s08 | -43.6514 | -28.3567 | 19.7268 | 0.013 | 0.0 | 0.0 | Setze die Heizung im Arbeitszimmer auf 21,5 Grad. | Setze die Heizung im Arbeitszimmer auf einundzwanzig Komma fünf Grad.
base16_a|avg | base16_a | avg | s09 | -42.6407 | -28.8753 | 19.4643 | 0.0042 | 0.0 | 0.0 | Der Raspberry Pi überträgt die Audio-Daten per WLAN an den Server. | Der Raspberry Pi überträgt die Audiodaten per WLAN an den Server.
base16_a|avg | base16_a | avg | s10 | -43.164 | -30.1033 | 20.2023 | 0.0076 | 0.0 | 0.0 | Erinnere mich morgen um 7.30 Uhr an den Müll. | Erinnere mich morgen um sieben Uhr dreißig an den Müll.
base16_a|evo4 | base16_a | evo4 | s01 | -48.8863 | -34.9289 | 24.0888 | 0.0056 | 0.0 | 0.0 | Schalte das Licht im Wohnzimmer auf 50%. | Schalte das Licht im Wohnzimmer auf fünfzig Prozent.
base16_a|evo4 | base16_a | evo4 | s02 | -50.2553 | -35.6974 | 22.8278 | 0.005 | 0.0 | 0.0 | Wie warm ist es im Badezimmer? | Wie warm ist es im Badezimmer?
base16_a|evo4 | base16_a | evo4 | s03 | -47.9125 | -33.3908 | 25.0476 | 0.0009 | 0.0 | 0.0 | Stelle einen Timer auf 3 Minuten. | Stelle einen Timer auf drei Minuten.
base16_a|evo4 | base16_a | evo4 | s04 | -51.1364 | -36.5504 | 22.9965 | 0.0172 | 0.1429 | 0.0208 | Die 12-Jährige übt Querflute in der Grünstraße. | Die Zwölfjährige übt Querflöte in der Grünstraße.
base16_a|evo4 | base16_a | evo4 | s05 | -49.5672 | -35.7629 | 23.6985 | 0.0026 | 0.1429 | 0.0652 | Öffne die Rouladen im Schlafzimmer zur Hälfte. | Öffne die Rollläden im Schlafzimmer zur Hälfte.
base16_a|evo4 | base16_a | evo4 | s06 | -52.0382 | -36.4465 | 22.0985 | 0.1777 | 0.4 | 0.0274 | Fischer's Fritz fischt frische Fische, frische Fische fischt Fischer's Fritz. | Fischers Fritz fischt frische Fische, frische Fische fischt Fischers Fritz.
base16_a|evo4 | base16_a | evo4 | s07 | -50.2811 | -35.6025 | 23.3365 | 0.0038 | 0.2 | 0.04 | Die Donaudampfschifffahrtsgesellschaft prüft den Wärmepunktenwartungsvertrag. | Die Donaudampfschifffahrtsgesellschaft prüft den Wärmepumpenwartungsvertrag.
base16_a|evo4 | base16_a | evo4 | s08 | -51.2604 | -35.0823 | 22.9102 | 0.0054 | 0.0 | 0.0 | Setze die Heizung im Arbeitszimmer auf 21,5 Grad. | Setze die Heizung im Arbeitszimmer auf einundzwanzig Komma fünf Grad.
base16_a|evo4 | base16_a | evo4 | s09 | -50.3114 | -35.2006 | 22.9331 | 0.0013 | 0.0 | 0.0 | Der Raspberry Pi überträgt die Audio-Daten per WLAN an den Server. | Der Raspberry Pi überträgt die Audiodaten per WLAN an den Server.
base16_a|evo4 | base16_a | evo4 | s10 | -49.8322 | -35.9064 | 24.165 | 0.0028 | 0.0 | 0.0 | Erinnere mich morgen um 7.30 Uhr an den Müll. | Erinnere mich morgen um sieben Uhr dreißig an den Müll.
base16_c|L | base16_c | L | s01 | -41.4988 | -27.0735 | 18.7562 | 0.0279 | 0.125 | 0.0392 | Scheite das Licht im Wohnzimmer auf 50 Prozent. | Schalte das Licht im Wohnzimmer auf fünfzig Prozent.
base16_c|L | base16_c | L | s02 | -41.8466 | -27.5597 | 19.0301 | 0.0381 | 0.0 | 0.0 | Wie warm ist es im Badezimmer? | Wie warm ist es im Badezimmer?
base16_c|L | base16_c | L | s03 | -41.3985 | -28.9405 | 18.0033 | 0.0054 | 0.3333 | 0.2571 | Stelle einen Timer auf dran. | Stelle einen Timer auf drei Minuten.
base16_c|L | base16_c | L | s04 | -43.9559 | -29.6434 | 16.9123 | 0.0831 | 0.1429 | 0.0208 | Die 12-jährige übt Querflute in der Grünstraße. | Die Zwölfjährige übt Querflöte in der Grünstraße.
base16_c|L | base16_c | L | s05 | -40.7763 | -28.0459 | 17.9797 | 0.0157 | 0.4286 | 0.2174 | Das sind die Ruhläden im Schlafzimmer zur Hälfte. | Öffne die Rollläden im Schlafzimmer zur Hälfte.
base16_c|L | base16_c | L | s06 | -42.453 | -26.7851 | 18.4929 | 0.3098 | 0.4 | 0.0274 | Fischer's Fritz fischt frische Fische. Frische Fische fischt Fischer's Fritz. | Fischers Fritz fischt frische Fische, frische Fische fischt Fischers Fritz.
base16_c|L | base16_c | L | s07 | -42.47 | -28.5651 | 17.838 | 0.0164 | 0.2 | 0.04 | Die Donaudampfschifffahrtsgesellschaft prüft den Wärmepunktenwartungsvertrag. | Die Donaudampfschifffahrtsgesellschaft prüft den Wärmepumpenwartungsvertrag.
base16_c|L | base16_c | L | s08 | -43.9096 | -28.2032 | 16.9936 | 0.0502 | 0.0 | 0.0 | Setze die Heizung im Arbeitszimmer auf 21,5 Grad. | Setze die Heizung im Arbeitszimmer auf einundzwanzig Komma fünf Grad.
base16_c|L | base16_c | L | s09 | -42.8757 | -29.0751 | 16.7633 | 0.012 | 0.0 | 0.0 | Der Raspberry Pi überträgt die Audio-Daten per WLAN an den Server. | Der Raspberry Pi überträgt die Audiodaten per WLAN an den Server.
base16_c|L | base16_c | L | s10 | -43.5055 | -29.8386 | 17.404 | 0.0219 | 0.0 | 0.0 | Erinnere mich morgen um 7.30 Uhr an den Müll. | Erinnere mich morgen um sieben Uhr dreißig an den Müll.
base16_c|R | base16_c | R | s01 | -40.7695 | -25.9402 | 20.809 | 0.0148 | 0.0 | 0.0 | Schalte das Licht im Wohnzimmer auf 50%. | Schalte das Licht im Wohnzimmer auf fünfzig Prozent.
base16_c|R | base16_c | R | s02 | -40.9394 | -25.0963 | 21.2475 | 0.017 | 0.1667 | 0.069 | Wie warm ist das im Badezimmer? | Wie warm ist es im Badezimmer?
base16_c|R | base16_c | R | s03 | -40.6756 | -27.8689 | 20.0818 | 0.0031 | 0.0 | 0.0 | Stelle einen Timer auf 3 Minuten. | Stelle einen Timer auf drei Minuten.
base16_c|R | base16_c | R | s04 | -43.4079 | -27.9347 | 18.75 | 0.0426 | 0.2857 | 0.0625 | Die 12-Jährige übt Querflute in der Grundstraße. | Die Zwölfjährige übt Querflöte in der Grünstraße.
base16_c|R | base16_c | R | s05 | -40.107 | -27.5407 | 20.0192 | 0.0076 | 0.4286 | 0.1739 | Öffne die Roller mit dem Schlafzimmer zur Hälfte. | Öffne die Rollläden im Schlafzimmer zur Hälfte.
base16_c|R | base16_c | R | s06 | -42.5098 | -26.4485 | 19.7097 | 0.1902 | 0.4 | 0.0274 | Fischer's Fritz fischt frische Fische, frische Fische fischt Fischer's Fritz. | Fischers Fritz fischt frische Fische, frische Fische fischt Fischers Fritz.
base16_c|R | base16_c | R | s07 | -41.8503 | -28.2149 | 19.7922 | 0.0078 | 0.2 | 0.04 | Die Donaudampfschifffahrtsgesellschaft prüft den Wärmepunktenwartungsvertrag. | Die Donaudampfschifffahrtsgesellschaft prüft den Wärmepumpenwartungsvertrag.
base16_c|R | base16_c | R | s08 | -42.9211 | -28.0325 | 19.3003 | 0.0225 | 0.0 | 0.0 | Setze die Heizung im Arbeitszimmer auf 21,5 Grad. | Setze die Heizung im Arbeitszimmer auf einundzwanzig Komma fünf Grad.
base16_c|R | base16_c | R | s09 | -42.2387 | -29.0751 | 18.7907 | 0.006 | 0.0 | 0.0 | Der Raspberry Pi überträgt die Audio-Daten per WLAN an den Server. | Der Raspberry Pi überträgt die Audiodaten per WLAN an den Server.
base16_c|R | base16_c | R | s10 | -42.5765 | -29.1834 | 19.6454 | 0.0107 | 0.0 | 0.0 | Erinnere mich morgen um 7.30 Uhr an den Müll. | Erinnere mich morgen um sieben Uhr dreißig an den Müll.
base16_c|avg | base16_c | avg | s01 | -41.2616 | -26.4884 | 21.6347 | 0.0086 | 0.125 | 0.0392 | Scheite das Licht im Wohnzimmer auf 50 Prozent. | Schalte das Licht im Wohnzimmer auf fünfzig Prozent.
base16_c|avg | base16_c | avg | s02 | -41.5701 | -26.7122 | 21.9619 | 0.0105 | 0.0 | 0.0 | Wie warm ist es im Badezimmer? | Wie warm ist es im Badezimmer?
base16_c|avg | base16_c | avg | s03 | -41.1107 | -28.4126 | 20.9423 | 0.0022 | 0.0 | 0.0 | Stelle einen Timer auf 3 Minuten. | Stelle einen Timer auf drei Minuten.
base16_c|avg | base16_c | avg | s04 | -44.0049 | -29.1367 | 19.5277 | 0.0238 | 0.1429 | 0.0208 | Die 12-Jährige übt Querflute in der Grünstraße. | Die Zwölfjährige übt Querflöte in der Grünstraße.
base16_c|avg | base16_c | avg | s05 | -40.5162 | -27.8876 | 20.8847 | 0.0055 | 0.1429 | 0.0652 | Öffne die Ruhläden im Schlafzimmer zur Hälfte. | Öffne die Rollläden im Schlafzimmer zur Hälfte.
base16_c|avg | base16_c | avg | s06 | -43.4544 | -27.6638 | 20.1198 | 0.1179 | 0.4 | 0.0274 | Fischer's Fritz fischt frische Fische. Frische Fische fischt Fischer's Fritz. | Fischers Fritz fischt frische Fische, frische Fische fischt Fischers Fritz.
base16_c|avg | base16_c | avg | s07 | -42.2934 | -28.7799 | 20.6735 | 0.0053 | 0.2 | 0.04 | Die Donaudampfschifffahrtsgesellschaft prüft den Wärmepunktenwartungsvertrag. | Die Donaudampfschifffahrtsgesellschaft prüft den Wärmepumpenwartungsvertrag.
base16_c|avg | base16_c | avg | s08 | -43.6818 | -28.2125 | 19.8992 | 0.014 | 0.0 | 0.0 | Setze die Heizung im Arbeitszimmer auf 21,5 Grad. | Setze die Heizung im Arbeitszimmer auf einundzwanzig Komma fünf Grad.
base16_c|avg | base16_c | avg | s09 | -42.6683 | -29.313 | 19.6565 | 0.0048 | 0.0 | 0.0 | Der Raspberry Pi überträgt die Audio-Daten per WLAN an den Server. | Der Raspberry Pi überträgt die Audiodaten per WLAN an den Server.
base16_c|avg | base16_c | avg | s10 | -43.2015 | -30.0144 | 20.3819 | 0.0073 | 0.0 | 0.0 | Erinnere mich morgen um 7.30 Uhr an den Müll. | Erinnere mich morgen um sieben Uhr dreißig an den Müll.
base16_c|evo4 | base16_c | evo4 | s01 | -48.5778 | -35.0966 | 23.8491 | 0.0056 | 0.0 | 0.0 | Schalte das Licht im Wohnzimmer auf 50%. | Schalte das Licht im Wohnzimmer auf fünfzig Prozent.
base16_c|evo4 | base16_c | evo4 | s02 | -50.8231 | -37.0046 | 22.6246 | 0.0048 | 0.0 | 0.0 | Wie warm ist es im Badezimmer? | Wie warm ist es im Badezimmer?
base16_c|evo4 | base16_c | evo4 | s03 | -47.8002 | -32.6142 | 24.8706 | 0.0008 | 0.0 | 0.0 | Stelle einen Timer auf 3 Minuten. | Stelle einen Timer auf drei Minuten.
base16_c|evo4 | base16_c | evo4 | s04 | -51.0361 | -36.6653 | 22.7957 | 0.0166 | 0.1429 | 0.0208 | Die 12-Jährige übt Querflute in der Grünstraße. | Die Zwölfjährige übt Querflöte in der Grünstraße.
base16_c|evo4 | base16_c | evo4 | s05 | -48.1778 | -35.9798 | 23.4584 | 0.0025 | 0.1429 | 0.087 | Öffne die Roller im Schlafzimmer zur Hälfte. | Öffne die Rollläden im Schlafzimmer zur Hälfte.
base16_c|evo4 | base16_c | evo4 | s06 | -51.4725 | -36.2331 | 21.8489 | 0.1732 | 0.4 | 0.0274 | Fischer's Fritz fischt frische Fische, frische Fische fischt Fischer's Fritz. | Fischers Fritz fischt frische Fische, frische Fische fischt Fischers Fritz.
base16_c|evo4 | base16_c | evo4 | s07 | -50.0751 | -36.2047 | 23.1214 | 0.0038 | 0.2 | 0.04 | Die Donaudampfschifffahrtsgesellschaft prüft den Wärmepunktenwartungsvertrag. | Die Donaudampfschifffahrtsgesellschaft prüft den Wärmepumpenwartungsvertrag.
base16_c|evo4 | base16_c | evo4 | s08 | -51.1377 | -35.1367 | 22.6638 | 0.0052 | 0.0 | 0.0 | Setze die Heizung im Arbeitszimmer auf 21,5 Grad. | Setze die Heizung im Arbeitszimmer auf einundzwanzig Komma fünf Grad.
base16_c|evo4 | base16_c | evo4 | s09 | -50.1238 | -35.5312 | 22.7169 | 0.0013 | 0.0 | 0.0 | Der Raspberry Pi überträgt die Audiodaten per WLAN an den Server. | Der Raspberry Pi überträgt die Audiodaten per WLAN an den Server.
base16_c|evo4 | base16_c | evo4 | s10 | -49.7485 | -36.0458 | 23.9482 | 0.0028 | 0.0 | 0.0 | Erinnere mich morgen um 7.30 Uhr an den Müll. | Erinnere mich morgen um sieben Uhr dreißig an den Müll.
base16_d|L | base16_d | L | s01 | -41.5726 | -26.9132 | 19.027 | 0.0275 | 0.0 | 0.0 | Schalte das Licht im Wohnzimmer auf 50%. | Schalte das Licht im Wohnzimmer auf fünfzig Prozent.
base16_d|L | base16_d | L | s02 | -41.944 | -27.4275 | 19.2887 | 0.0371 | 0.0 | 0.0 | Wie warm ist es im Badezimmer? | Wie warm ist es im Badezimmer?
base16_d|L | base16_d | L | s03 | -41.4608 | -29.0679 | 18.3057 | 0.006 | 0.0 | 0.0 | Stelle einen Timer auf 3 Minuten. | Stelle einen Timer auf drei Minuten.
base16_d|L | base16_d | L | s04 | -43.934 | -29.4527 | 17.2115 | 0.0786 | 0.2857 | 0.1042 | Die 12-jährige im Querflut in der Grünstraße. | Die Zwölfjährige übt Querflöte in der Grünstraße.
base16_d|L | base16_d | L | s05 | -42.1055 | -29.0378 | 18.2246 | 0.0148 | 0.1429 | 0.0652 | Öffne die Ruhläden im Schlafzimmer zur Hälfte. | Öffne die Rollläden im Schlafzimmer zur Hälfte.
base16_d|L | base16_d | L | s06 | -42.4431 | -26.8605 | 18.766 | 0.3096 | 0.4 | 0.0822 | Fischer Spritz Fischt Frische Fische. Frische Fische Fischt Fischer Spritz. | Fischers Fritz fischt frische Fische, frische Fische fischt Fischers Fritz.
base16_d|L | base16_d | L | s07 | -42.4274 | -28.766 | 18.1103 | 0.0172 | 0.2 | 0.04 | Die Donaudampfschifffahrtsgesellschaft prüft den Wärmepunktenwartungsvertrag. | Die Donaudampfschifffahrtsgesellschaft prüft den Wärmepumpenwartungsvertrag.
base16_d|L | base16_d | L | s08 | -43.9181 | -28.9053 | 17.2608 | 0.0483 | 0.0 | 0.0 | Setze die Heizung im Arbeitszimmer auf 21,5 Grad. | Setze die Heizung im Arbeitszimmer auf einundzwanzig Komma fünf Grad.
base16_d|L | base16_d | L | s09 | -42.8157 | -28.9631 | 17.0615 | 0.0098 | 0.0 | 0.0 | Der Raspberry Pi überträgt die Audio-Daten per Wlan an den Server. | Der Raspberry Pi überträgt die Audiodaten per WLAN an den Server.
base16_d|L | base16_d | L | s10 | -43.5017 | -30.3037 | 17.6703 | 0.0208 | 0.0 | 0.0 | Erinnere mich morgen um 7.30 Uhr an den Müll. | Erinnere mich morgen um sieben Uhr dreißig an den Müll.
base16_d|R | base16_d | R | s01 | -40.846 | -25.7993 | 20.8001 | 0.0144 | 0.0 | 0.0 | Schalte das Licht im Wohnzimmer auf 50%. | Schalte das Licht im Wohnzimmer auf fünfzig Prozent.
base16_d|R | base16_d | R | s02 | -41.0352 | -25.3873 | 21.2337 | 0.0172 | 0.1667 | 0.069 | Wie warm ist das im Badezimmer? | Wie warm ist es im Badezimmer?
base16_d|R | base16_d | R | s03 | -40.6966 | -28.1152 | 20.1544 | 0.0034 | 0.0 | 0.0 | Stelle einen Timer auf 3 Minuten. | Stelle einen Timer auf drei Minuten.
base16_d|R | base16_d | R | s04 | -43.3955 | -27.988 | 18.7858 | 0.0427 | 0.1429 | 0.0208 | Die 12-jährige übt Querflute in der Grünstraße. | Die Zwölfjährige übt Querflöte in der Grünstraße.
base16_d|R | base16_d | R | s05 | -41.3552 | -27.9128 | 20.0149 | 0.007 | 0.1429 | 0.087 | Öffne die Roller im Schlafzimmer zur Hälfte. | Öffne die Rollläden im Schlafzimmer zur Hälfte.
base16_d|R | base16_d | R | s06 | -42.4997 | -26.8123 | 19.7264 | 0.1904 | 0.4 | 0.0274 | Fischer's Fritz fischt frische Fische, frische Fische fischt Fischer's Fritz. | Fischers Fritz fischt frische Fische, frische Fische fischt Fischers Fritz.
base16_d|R | base16_d | R | s07 | -41.8219 | -27.9923 | 19.7773 | 0.008 | 0.2 | 0.0667 | Die Donaudampfschifffahrtsgesellschaft prüft den Werbepunktenwartungsvertrag. | Die Donaudampfschifffahrtsgesellschaft prüft den Wärmepumpenwartungsvertrag.
base16_d|R | base16_d | R | s08 | -42.9471 | -28.3964 | 19.2898 | 0.0216 | 0.0 | 0.0 | Setze die Heizung im Arbeitszimmer auf 21,5 Grad. | Setze die Heizung im Arbeitszimmer auf einundzwanzig Komma fünf Grad.
base16_d|R | base16_d | R | s09 | -42.1848 | -29.3221 | 18.8232 | 0.005 | 0.0 | 0.0 | Der Raspberry Pi überträgt die Audio-Daten per WLAN an den Server. | Der Raspberry Pi überträgt die Audiodaten per WLAN an den Server.
base16_d|R | base16_d | R | s10 | -42.5665 | -28.9429 | 19.6628 | 0.0107 | 0.0 | 0.0 | Erinnere mich morgen um 7.30 Uhr an den Müll. | Erinnere mich morgen um sieben Uhr dreißig an den Müll.
base16_d|avg | base16_d | avg | s01 | -41.3392 | -26.3439 | 21.7721 | 0.008 | 0.0 | 0.0 | Schalte das Licht im Wohnzimmer auf 50%. | Schalte das Licht im Wohnzimmer auf fünfzig Prozent.
base16_d|avg | base16_d | avg | s02 | -41.6667 | -26.6695 | 22.0902 | 0.0098 | 0.1667 | 0.069 | Wie warm ist das im Badezimmer? | Wie warm ist es im Badezimmer?
base16_d|avg | base16_d | avg | s03 | -41.1542 | -28.6392 | 21.1401 | 0.0026 | 0.0 | 0.0 | Stelle einen Timer auf 3 Minuten. | Stelle einen Timer auf drei Minuten.
base16_d|avg | base16_d | avg | s04 | -43.9887 | -29.1559 | 19.7078 | 0.0229 | 0.1429 | 0.0208 | Die 12-jährige übt Querflute in der Grünstraße. | Die Zwölfjährige übt Querflöte in der Grünstraße.
base16_d|avg | base16_d | avg | s05 | -41.8309 | -28.7728 | 21.0122 | 0.0043 | 0.4286 | 0.2391 | Öffne die Ruhlein mit dem Schlafzimmer zur Hälfte. | Öffne die Rollläden im Schlafzimmer zur Hälfte.
base16_d|avg | base16_d | avg | s06 | -43.4391 | -27.4641 | 20.275 | 0.1178 | 0.4 | 0.0274 | Fischer's Fritz fischt frische Fische, frische Fische fischt Fischer's Fritz. | Fischers Fritz fischt frische Fische, frische Fische fischt Fischers Fritz.
base16_d|avg | base16_d | avg | s07 | -42.2509 | -28.4403 | 20.8091 | 0.0057 | 0.2 | 0.04 | Die Donaudampfschifffahrtsgesellschaft prüft den Wärmepunktenwartungsvertrag. | Die Donaudampfschifffahrtsgesellschaft prüft den Wärmepumpenwartungsvertrag.
base16_d|avg | base16_d | avg | s08 | -43.6982 | -28.8674 | 20.0329 | 0.0126 | 0.0 | 0.0 | Setze die Heizung im Arbeitszimmer auf 21,5 Grad. | Setze die Heizung im Arbeitszimmer auf einundzwanzig Komma fünf Grad.
base16_d|avg | base16_d | avg | s09 | -42.6077 | -29.2785 | 19.8298 | 0.0033 | 0.0 | 0.0 | Der Raspberry Pi überträgt die Audio-Daten per WLAN an den Server. | Der Raspberry Pi überträgt die Audiodaten per WLAN an den Server.
base16_d|avg | base16_d | avg | s10 | -43.1912 | -30.3485 | 20.5319 | 0.0067 | 0.0 | 0.0 | Erinnere mich morgen um 7.30 Uhr an den Müll. | Erinnere mich morgen um sieben Uhr dreißig an den Müll.
base16_d|evo4 | base16_d | evo4 | s01 | -49.1196 | -35.3788 | 24.4582 | 0.0056 | 0.0 | 0.0 | Schalte das Licht im Wohnzimmer auf 50%. | Schalte das Licht im Wohnzimmer auf fünfzig Prozent.
base16_d|evo4 | base16_d | evo4 | s02 | -51.3087 | -36.9074 | 23.2176 | 0.0048 | 0.0 | 0.0 | Wie warm ist es im Badezimmer? | Wie warm ist es im Badezimmer?
base16_d|evo4 | base16_d | evo4 | s03 | -48.0117 | -33.2704 | 25.4536 | 0.0008 | 0.0 | 0.0 | Stelle einen Timer auf 3 Minuten. | Stelle einen Timer auf drei Minuten.
base16_d|evo4 | base16_d | evo4 | s04 | -49.5741 | -36.6494 | 23.41 | 0.0167 | 0.1429 | 0.0208 | Die Zwölfjährige übt Querflute in der Grünstraße. | Die Zwölfjährige übt Querflöte in der Grünstraße.
base16_d|evo4 | base16_d | evo4 | s05 | -49.5689 | -36.3025 | 24.0751 | 0.0026 | 0.1429 | 0.1304 | Öffne die Rundern im Schlafzimmer zur Hälfte. | Öffne die Rollläden im Schlafzimmer zur Hälfte.
base16_d|evo4 | base16_d | evo4 | s06 | -51.8151 | -35.6622 | 22.4731 | 0.1744 | 0.4 | 0.0274 | Fischer's Fritz fischt frische Fische, frische Fische fischt Fischer's Fritz. | Fischers Fritz fischt frische Fische, frische Fische fischt Fischers Fritz.
base16_d|evo4 | base16_d | evo4 | s07 | -49.1457 | -34.9934 | 23.7135 | 0.0038 | 0.2 | 0.0267 | Die Donaudampfschifffahrtsgesellschaft prüft den Wärmepundenwartungsvertrag. | Die Donaudampfschifffahrtsgesellschaft prüft den Wärmepumpenwartungsvertrag.
base16_d|evo4 | base16_d | evo4 | s08 | -51.1478 | -35.0101 | 23.2744 | 0.0052 | 0.0 | 0.0 | Setze die Heizung im Arbeitszimmer auf 21,5 Grad. | Setze die Heizung im Arbeitszimmer auf einundzwanzig Komma fünf Grad.
base16_d|evo4 | base16_d | evo4 | s09 | -49.0696 | -35.3375 | 23.3563 | 0.0013 | 0.0 | 0.0 | Der Raspberry Pi überträgt die Audiodaten per WLAN an den Server. | Der Raspberry Pi überträgt die Audiodaten per WLAN an den Server.
base16_d|evo4 | base16_d | evo4 | s10 | -50.09 | -36.1529 | 24.5527 | 0.0028 | 0.0 | 0.0 | Erinnere mich morgen um 7.30 Uhr an den Müll. | Erinnere mich morgen um sieben Uhr dreißig an den Müll.
base48_c|L | base48_c | L | s01 | -41.5476 | -27.109 | 18.8495 | 0.0153 | 0.125 | 0.0392 | Scheite das Licht im Wohnzimmer auf 50 Prozent. | Schalte das Licht im Wohnzimmer auf fünfzig Prozent.
base48_c|L | base48_c | L | s02 | -41.924 | -27.5718 | 19.034 | 0.0097 | 0.0 | 0.0 | Wie warm ist es im Badezimmer? | Wie warm ist es im Badezimmer?
base48_c|L | base48_c | L | s03 | -41.5133 | -28.882 | 18.1512 | 0.0041 | 0.0 | 0.0 | Stelle einen Timer auf 3 Minuten. | Stelle einen Timer auf drei Minuten.
base48_c|L | base48_c | L | s04 | -43.8907 | -29.3747 | 16.9248 | 0.0514 | 0.1429 | 0.0208 | Die 12-jährige übt Querflute in der Grünstraße. | Die Zwölfjährige übt Querflöte in der Grünstraße.
base48_c|L | base48_c | L | s05 | -42.1317 | -28.4717 | 18.1006 | 0.0087 | 0.4286 | 0.1739 | Öffne die Roller mit dem Schlafzimmer zur Hälfte. | Öffne die Rollläden im Schlafzimmer zur Hälfte.
base48_c|L | base48_c | L | s06 | -42.4081 | -25.6013 | 18.322 | 0.2731 | 0.4 | 0.0822 | Fischer Spritz Fischt Frische Fische. Frische Fische Fischt Fischer Spritz. | Fischers Fritz fischt frische Fische, frische Fische fischt Fischers Fritz.
base48_c|L | base48_c | L | s07 | -42.4528 | -28.8314 | 17.9557 | 0.011 | 0.2 | 0.04 | Die Donaudampfschifffahrtsgesellschaft prüft den Wärmepunktenwartungsvertrag. | Die Donaudampfschifffahrtsgesellschaft prüft den Wärmepumpenwartungsvertrag.
base48_c|L | base48_c | L | s08 | -43.8313 | -28.189 | 17.0034 | 0.0173 | 0.0 | 0.0 | Setze die Heizung im Arbeitszimmer auf 21,5 Grad. | Setze die Heizung im Arbeitszimmer auf einundzwanzig Komma fünf Grad.
base48_c|L | base48_c | L | s09 | -42.8291 | -28.8021 | 16.9087 | 0.0072 | 0.0 | 0.0 | Der Raspberry Pi überträgt die Audio-Daten per WLAN an den Server. | Der Raspberry Pi überträgt die Audiodaten per WLAN an den Server.
base48_c|L | base48_c | L | s10 | -43.4387 | -29.5322 | 17.5275 | 0.0116 | 0.0 | 0.0 | Erinnere mich morgen um 7.30 Uhr an den Müll. | Erinnere mich morgen um sieben Uhr dreißig an den Müll.
base48_c|R | base48_c | R | s01 | -40.8723 | -25.9563 | 21.5455 | 0.0086 | 0.0 | 0.0 | Schalte das Licht im Wohnzimmer auf 50%. | Schalte das Licht im Wohnzimmer auf fünfzig Prozent.
base48_c|R | base48_c | R | s02 | -41.0798 | -25.2111 | 21.915 | 0.0042 | 0.0 | 0.0 | Wie warm ist es im Badezimmer? | Wie warm ist es im Badezimmer?
base48_c|R | base48_c | R | s03 | -40.7656 | -27.4898 | 20.8961 | 0.002 | 0.0 | 0.0 | Stelle einen Timer auf 3 Minuten. | Stelle einen Timer auf drei Minuten.
base48_c|R | base48_c | R | s04 | -43.4092 | -27.5276 | 19.5023 | 0.0286 | 0.1429 | 0.0208 | Die 12-jährige übt Querflute in der Grünstraße. | Die Zwölfjährige übt Querflöte in der Grünstraße.
base48_c|R | base48_c | R | s05 | -41.5018 | -28.0072 | 20.7579 | 0.0041 | 0.4286 | 0.1739 | Öffne die Roller mit dem Schlafzimmer zur Hälfte. | Öffne die Rollläden im Schlafzimmer zur Hälfte.
base48_c|R | base48_c | R | s06 | -42.5565 | -26.5667 | 20.2819 | 0.1704 | 0.4 | 0.0822 | Fischer Spritz fischt frische Fische, frische Fische fischt Fischer Spritz. | Fischers Fritz fischt frische Fische, frische Fische fischt Fischers Fritz.
base48_c|R | base48_c | R | s07 | -41.8834 | -27.7762 | 20.5395 | 0.005 | 0.2 | 0.04 | Die Donaudampfschifffahrtsgesellschaft prüft den Wärmepunktenwartungsvertrag. | Die Donaudampfschifffahrtsgesellschaft prüft den Wärmepumpenwartungsvertrag.
base48_c|R | base48_c | R | s08 | -42.9721 | -28.2222 | 19.9819 | 0.0081 | 0.0 | 0.0 | Setze die Heizung im Arbeitszimmer auf 21,5 Grad. | Setze die Heizung im Arbeitszimmer auf einundzwanzig Komma fünf Grad.
base48_c|R | base48_c | R | s09 | -42.2495 | -28.5929 | 19.5512 | 0.0031 | 0.0 | 0.0 | Der Raspberry Pi überträgt die Audio-Daten per WLAN an den Server. | Der Raspberry Pi überträgt die Audiodaten per WLAN an den Server.
base48_c|R | base48_c | R | s10 | -42.5758 | -28.8535 | 20.4184 | 0.0055 | 0.0 | 0.0 | Erinnere mich morgen um 7.30 Uhr an den Müll. | Erinnere mich morgen um sieben Uhr dreißig an den Müll.
base48_c|avg | base48_c | avg | s01 | -41.3523 | -26.5136 | 22.062 | 0.0046 | 0.0 | 0.0 | Schalte das Licht im Wohnzimmer auf 50 Prozent. | Schalte das Licht im Wohnzimmer auf fünfzig Prozent.
base48_c|avg | base48_c | avg | s02 | -41.6938 | -26.522 | 22.3362 | 0.0031 | 0.1667 | 0.069 | Wie warm ist das im Badezimmer? | Wie warm ist es im Badezimmer?
base48_c|avg | base48_c | avg | s03 | -41.2242 | -28.2672 | 21.4098 | 0.0014 | 0.0 | 0.0 | Stelle einen Timer auf 3 Minuten. | Stelle einen Timer auf drei Minuten.
base48_c|avg | base48_c | avg | s04 | -43.984 | -28.7871 | 19.9686 | 0.0156 | 0.1429 | 0.0208 | Die 12-jährige übt Querflute in der Grünstraße. | Die Zwölfjährige übt Querflöte in der Grünstraße.
base48_c|avg | base48_c | avg | s05 | -41.9311 | -28.3223 | 21.3135 | 0.0027 | 0.4286 | 0.1739 | Öffne die Roller mit dem Schlafzimmer zur Hälfte. | Öffne die Rollläden im Schlafzimmer zur Hälfte.
base48_c|avg | base48_c | avg | s06 | -43.4797 | -27.4737 | 20.4262 | 0.104 | 0.4 | 0.0822 | Fischer Spritz fischt frische Fische, frische Fische fischt Fischer Spritz. | Fischers Fritz fischt frische Fische, frische Fische fischt Fischers Fritz.
base48_c|avg | base48_c | avg | s07 | -42.3161 | -28.5498 | 21.0979 | 0.0033 | 0.2 | 0.04 | Die Donaudampfschifffahrtsgesellschaft prüft den Wärmepunktenwartungsvertrag. | Die Donaudampfschifffahrtsgesellschaft prüft den Wärmepumpenwartungsvertrag.
base48_c|avg | base48_c | avg | s08 | -43.6905 | -28.3673 | 20.2907 | 0.0052 | 0.0 | 0.0 | Setze die Heizung im Arbeitszimmer auf 21,5 Grad. | Setze die Heizung im Arbeitszimmer auf einundzwanzig Komma fünf Grad.
base48_c|avg | base48_c | avg | s09 | -42.6642 | -29.3285 | 20.0966 | 0.0022 | 0.0 | 0.0 | Der Raspberry Pi überträgt die Audio-Daten per WLAN an den Server. | Der Raspberry Pi überträgt die Audiodaten per WLAN an den Server.
base48_c|avg | base48_c | avg | s10 | -43.1819 | -30.2743 | 20.8292 | 0.0033 | 0.0 | 0.0 | Erinnere mich morgen um 7.30 Uhr an den Müll. | Erinnere mich morgen um sieben Uhr dreißig an den Müll.
base48_c|evo4 | base48_c | evo4 | s01 | -49.0204 | -35.6096 | 24.1091 | 0.0056 | 0.0 | 0.0 | Schalte das Licht im Wohnzimmer auf 50 Prozent. | Schalte das Licht im Wohnzimmer auf fünfzig Prozent.
base48_c|evo4 | base48_c | evo4 | s02 | -50.7587 | -36.0887 | 22.8848 | 0.0049 | 0.0 | 0.0 | Wie warm ist es im Badezimmer? | Wie warm ist es im Badezimmer?
base48_c|evo4 | base48_c | evo4 | s03 | -47.9509 | -33.4683 | 25.0915 | 0.0008 | 0.0 | 0.0 | Stelle einen Timer auf 3 Minuten. | Stelle einen Timer auf drei Minuten.
base48_c|evo4 | base48_c | evo4 | s04 | -50.928 | -36.7619 | 23.0148 | 0.0167 | 0.1429 | 0.0208 | Die 12-Jährige übt Querflute in der Grünstraße. | Die Zwölfjährige übt Querflöte in der Grünstraße.
base48_c|evo4 | base48_c | evo4 | s05 | -49.6774 | -35.9772 | 23.7076 | 0.0025 | 0.1429 | 0.0435 | Öffne die Rollerden im Schlafzimmer zur Hälfte. | Öffne die Rollläden im Schlafzimmer zur Hälfte.
base48_c|evo4 | base48_c | evo4 | s06 | -51.9065 | -36.103 | 22.1037 | 0.1749 | 0.0 | 0.0 | Fischers Fritz fischt frische Fische, frische Fische fischt Fischers Fritz. | Fischers Fritz fischt frische Fische, frische Fische fischt Fischers Fritz.
base48_c|evo4 | base48_c | evo4 | s07 | -50.0311 | -35.6625 | 23.371 | 0.0038 | 0.2 | 0.04 | Die Donaudampfschifffahrtsgesellschaft prüft den Wärmepunktenwartungsvertrag. | Die Donaudampfschifffahrtsgesellschaft prüft den Wärmepumpenwartungsvertrag.
base48_c|evo4 | base48_c | evo4 | s08 | -51.1724 | -34.9758 | 22.919 | 0.0052 | 0.0 | 0.0 | Setze die Heizung im Arbeitszimmer auf 21,5 Grad. | Setze die Heizung im Arbeitszimmer auf einundzwanzig Komma fünf Grad.
base48_c|evo4 | base48_c | evo4 | s09 | -50.3226 | -35.8041 | 22.9754 | 0.0013 | 0.0 | 0.0 | Der Raspberry Pi überträgt die Audiodaten per WLAN an den Server. | Der Raspberry Pi überträgt die Audiodaten per WLAN an den Server.
base48_c|evo4 | base48_c | evo4 | s10 | -50.0593 | -35.7701 | 24.1813 | 0.0028 | 0.0 | 0.0 | Erinnere mich morgen um 7.30 Uhr an den Müll. | Erinnere mich morgen um sieben Uhr dreißig an den Müll.
boost0|L | boost0 | L | s01 | -61.2965 | -47.219 | 18.505 | 0.0287 | 0.0 | 0.0 | Schalte das Licht im Wohnzimmer auf 50 Prozent. | Schalte das Licht im Wohnzimmer auf fünfzig Prozent.
boost0|L | boost0 | L | s02 | -61.6802 | -47.814 | 18.8014 | 0.0396 | 0.0 | 0.0 | Wie warm ist es im Badezimmer? | Wie warm ist es im Badezimmer?
boost0|L | boost0 | L | s03 | -61.183 | -48.2141 | 17.7998 | 0.0072 | 0.1667 | 0.1143 | Ich stelle einen Timer auf 3 Minuten. | Stelle einen Timer auf drei Minuten.
boost0|L | boost0 | L | s04 | -63.64 | -49.2263 | 16.7407 | 0.0841 | 0.1429 | 0.0208 | Die 12-jährige übt Querflute in der Grünstraße. | Die Zwölfjährige übt Querflöte in der Grünstraße.
boost0|L | boost0 | L | s05 | -61.8635 | -48.6336 | 17.7541 | 0.0176 | 0.7143 | 0.413 | dass mir die Ruhlein mit dem Schlafzimmer zur Hälfte. | Öffne die Rollläden im Schlafzimmer zur Hälfte.
boost0|L | boost0 | L | s06 | -62.1661 | -45.314 | 18.2866 | 0.3118 | 0.4 | 0.0822 | Fischer Spritz fischt frische Fische, frische Fische fischt Fischer Spritz. | Fischers Fritz fischt frische Fische, frische Fische fischt Fischers Fritz.
boost0|L | boost0 | L | s07 | -62.2175 | -48.9657 | 17.5948 | 0.018 | 0.2 | 0.04 | Die Donaudampfschifffahrtsgesellschaft prüft den Wärmepunktenwartungsvertrag. | Die Donaudampfschifffahrtsgesellschaft prüft den Wärmepumpenwartungsvertrag.
boost0|L | boost0 | L | s08 | -63.6187 | -48.1158 | 16.7889 | 0.0511 | 0.0 | 0.0 | Setze die Heizung im Arbeitszimmer auf 21,5 Grad. | Setze die Heizung im Arbeitszimmer auf einundzwanzig Komma fünf Grad.
boost0|L | boost0 | L | s09 | -62.5832 | -49.4594 | 16.5705 | 0.0132 | 0.0909 | 0.0312 | Der Raspberry Pi überträgt die Audio-Datmi per WLAN an den Server. | Der Raspberry Pi überträgt die Audiodaten per WLAN an den Server.
boost0|L | boost0 | L | s10 | -63.2202 | -49.8625 | 17.1862 | 0.0228 | 0.1 | 0.0185 | Erinnere dich morgen um 7.30 Uhr an den Müll. | Erinnere mich morgen um sieben Uhr dreißig an den Müll.
boost0|R | boost0 | R | s01 | -60.3363 | -45.4098 | 20.5095 | 0.0153 | 0.0 | 0.0 | Schalte das Licht im Wohnzimmer auf 50% | Schalte das Licht im Wohnzimmer auf fünfzig Prozent.
boost0|R | boost0 | R | s02 | -60.5362 | -44.8155 | 20.9595 | 0.0182 | 0.1667 | 0.069 | Wie warm ist das im Badezimmer? | Wie warm ist es im Badezimmer?
boost0|R | boost0 | R | s03 | -60.2353 | -47.1282 | 19.8559 | 0.004 | 0.0 | 0.0 | Stelle einen Timer auf 3 Minuten. | Stelle einen Timer auf drei Minuten.
boost0|R | boost0 | R | s04 | -62.8714 | -46.8322 | 18.5387 | 0.0446 | 0.1429 | 0.0208 | Die 12-jährige übt Querflute in der Grünstraße. | Die Zwölfjährige übt Querflöte in der Grünstraße.
boost0|R | boost0 | R | s05 | -60.9281 | -47.6239 | 19.7459 | 0.0085 | 0.4286 | 0.2391 | Öffne die Runder mit dem Schlafzimmer zur Hälfte. | Öffne die Rollläden im Schlafzimmer zur Hälfte.
boost0|R | boost0 | R | s06 | -61.9536 | -46.3482 | 19.4776 | 0.192 | 0.4 | 0.0822 | Fischer Spritz fischt frische Fische, frische Fische fischt Fischer Spritz. | Fischers Fritz fischt frische Fische, frische Fische fischt Fischers Fritz.
boost0|R | boost0 | R | s07 | -61.3209 | -47.4628 | 19.5333 | 0.0086 | 0.2 | 0.0667 | Die Donaudampfschifffahrtsgesellschaft prüft den Werbepunktenwartungsvertrag. | Die Donaudampfschifffahrtsgesellschaft prüft den Wärmepumpenwartungsvertrag.
boost0|R | boost0 | R | s08 | -62.3858 | -47.5889 | 19.0651 | 0.0232 | 0.0 | 0.0 | Setze die Heizung im Arbeitszimmer auf 21,5 Grad. | Setze die Heizung im Arbeitszimmer auf einundzwanzig Komma fünf Grad.
boost0|R | boost0 | R | s09 | -61.6853 | -48.5658 | 18.5486 | 0.0064 | 0.0 | 0.0 | Der Raspberry Pi überträgt die Audio-Daten per WLAN an den Server. | Der Raspberry Pi überträgt die Audiodaten per WLAN an den Server.
boost0|R | boost0 | R | s10 | -62.0538 | -48.0151 | 19.3867 | 0.0116 | 0.0 | 0.0 | Erinnere mich morgen um 7.30 Uhr an den Müll. | Erinnere mich morgen um sieben Uhr dreißig an den Müll.
boost0|avg | boost0 | avg | s01 | -60.9444 | -46.2674 | 21.4958 | 0.0088 | 0.0 | 0.0 | Schalte das Licht im Wohnzimmer auf 50% | Schalte das Licht im Wohnzimmer auf fünfzig Prozent.
boost0|avg | boost0 | avg | s02 | -61.2826 | -46.4326 | 21.8365 | 0.0107 | 0.1667 | 0.069 | Wie warm ist das im Badezimmer? | Wie warm ist es im Badezimmer?
boost0|avg | boost0 | avg | s03 | -60.7928 | -47.6542 | 20.8661 | 0.0033 | 0.0 | 0.0 | Stelle einen Timer auf 3 Minuten. | Stelle einen Timer auf drei Minuten.
boost0|avg | boost0 | avg | s04 | -63.5661 | -48.1479 | 19.4776 | 0.0258 | 0.1429 | 0.0208 | Die 12-jährige übt Querflute in der Grünstraße. | Die Zwölfjährige übt Querflöte in der Grünstraße.
boost0|avg | boost0 | avg | s05 | -61.498 | -48.1479 | 20.7699 | 0.0061 | 0.2857 | 0.087 | Öffnen die Ruhläden im Schlafzimmer zur Hälfte. | Öffne die Rollläden im Schlafzimmer zur Hälfte.
boost0|avg | boost0 | avg | s06 | -63.0475 | -47.3709 | 20.0191 | 0.1168 | 0.4 | 0.0822 | Fischer Spritz fischt frische Fische, frische Fische fischt Fischer Spritz. | Fischers Fritz fischt frische Fische, frische Fische fischt Fischers Fritz.
boost0|avg | boost0 | avg | s07 | -61.9036 | -48.2158 | 20.5582 | 0.0061 | 0.2 | 0.04 | Die Donaudampfschifffahrtsgesellschaft prüft den Wärmepunktenwartungsvertrag. | Die Donaudampfschifffahrtsgesellschaft prüft den Wärmepumpenwartungsvertrag.
boost0|avg | boost0 | avg | s08 | -63.2644 | -48.0804 | 19.8174 | 0.0139 | 0.0 | 0.0 | Setze die Heizung im Arbeitszimmer auf 21,5 Grad. | Setze die Heizung im Arbeitszimmer auf einundzwanzig Komma fünf Grad.
boost0|avg | boost0 | avg | s09 | -62.2382 | -49.0011 | 19.5747 | 0.0052 | 0.0909 | 0.0781 | Der Raspberry Pi überträgt die Audiow per Wlan an den Server. | Der Raspberry Pi überträgt die Audiodaten per WLAN an den Server.
boost0|avg | boost0 | avg | s10 | -62.7861 | -49.8234 | 20.2819 | 0.0078 | 0.0 | 0.0 | Erinnere mich morgen um 7.30 Uhr an den Müll. | Erinnere mich morgen um sieben Uhr dreißig an den Müll.
boost0|evo4 | boost0 | evo4 | s01 | -48.7598 | -35.1476 | 23.4338 | 0.0056 | 0.0 | 0.0 | Schalte das Licht im Wohnzimmer auf 50%. | Schalte das Licht im Wohnzimmer auf fünfzig Prozent.
boost0|evo4 | boost0 | evo4 | s02 | -51.4334 | -36.8168 | 22.1925 | 0.0049 | 0.0 | 0.0 | Wie warm ist es im Badezimmer? | Wie warm ist es im Badezimmer?
boost0|evo4 | boost0 | evo4 | s03 | -48.0517 | -33.2384 | 24.4142 | 0.0008 | 0.0 | 0.0 | Stelle einen Timer auf 3 Minuten. | Stelle einen Timer auf drei Minuten.
boost0|evo4 | boost0 | evo4 | s04 | -51.0506 | -36.5635 | 22.3739 | 0.0168 | 0.1429 | 0.0208 | Die 12-Jährige übt Querflute in der Grünstraße. | Die Zwölfjährige übt Querflöte in der Grünstraße.
boost0|evo4 | boost0 | evo4 | s05 | -48.7881 | -35.0687 | 23.0338 | 0.0026 | 0.1429 | 0.087 | Öffne die Roller im Schlafzimmer zur Hälfte. | Öffne die Rollläden im Schlafzimmer zur Hälfte.
boost0|evo4 | boost0 | evo4 | s06 | -49.8551 | -35.2761 | 21.4625 | 0.176 | 0.4 | 0.0274 | Fischer's Fritz fischt frische Fische, frische Fische fischt Fischer's Fritz. | Fischers Fritz fischt frische Fische, frische Fische fischt Fischers Fritz.
boost0|evo4 | boost0 | evo4 | s07 | -50.2198 | -35.7549 | 22.7066 | 0.0038 | 0.2 | 0.04 | Die Donaudampfschifffahrtsgesellschaft prüft den Wärmepunktenwartungsvertrag. | Die Donaudampfschifffahrtsgesellschaft prüft den Wärmepumpenwartungsvertrag.
boost0|evo4 | boost0 | evo4 | s08 | -51.0269 | -35.007 | 22.2565 | 0.0053 | 0.0 | 0.0 | Setze die Heizung im Arbeitszimmer auf 21,5 Grad. | Setze die Heizung im Arbeitszimmer auf einundzwanzig Komma fünf Grad.
boost0|evo4 | boost0 | evo4 | s09 | -49.1622 | -34.3132 | 22.3135 | 0.0013 | 0.0 | 0.0 | Der Raspberry Pi überträgt die Audiodaten per WLAN an den Server. | Der Raspberry Pi überträgt die Audiodaten per WLAN an den Server.
boost0|evo4 | boost0 | evo4 | s10 | -49.9333 | -35.9663 | 23.5422 | 0.0028 | 0.0 | 0.0 | Erinnere mich morgen um 7.30 Uhr an den Müll. | Erinnere mich morgen um sieben Uhr dreißig an den Müll.
boost1|L | boost1 | L | s01 | -48.918 | -34.2177 | 18.8883 | 0.0289 | 0.0 | 0.0 | Schalte das Licht im Wohnzimmer auf 50 Prozent. | Schalte das Licht im Wohnzimmer auf fünfzig Prozent.
boost1|L | boost1 | L | s02 | -49.2955 | -35.3201 | 19.1457 | 0.039 | 0.1667 | 0.069 | Wie warm ist das im Badezimmer? | Wie warm ist es im Badezimmer?
boost1|L | boost1 | L | s03 | -48.8288 | -36.2712 | 18.1699 | 0.0068 | 0.0 | 0.0 | Stelle einen Timer auf 3 Minuten. | Stelle einen Timer auf drei Minuten.
boost1|L | boost1 | L | s04 | -51.2629 | -37.0846 | 17.0878 | 0.0831 | 0.1429 | 0.0208 | Die 12-jährige übt Querflute in der Grünstraße. | Die Zwölfjährige übt Querflöte in der Grünstraße.
boost1|L | boost1 | L | s05 | -49.5275 | -36.2024 | 18.1004 | 0.0147 | 0.4286 | 0.2609 | Das sind die Ruhläuten im Schlafzimmer zur Hälfte. | Öffne die Rollläden im Schlafzimmer zur Hälfte.
boost1|L | boost1 | L | s06 | -49.7777 | -34.0024 | 18.6587 | 0.3089 | 7.3 | 6.274 | Fische, Fische, Fische, Fische, Fische, Fische, Fische, Fische, Fische, Fische, Fische, Fische, Fische, Fische, Fische, Fische, Fische, Fische, Fische, Fische, Fische, Fische, Fische, Fische, Fische, Fische, Fische, Fische, Fische, Fische, Fische, Fische, Fische, Fische, Fische, Fische, Fische, Fische, Fische, Fische, Fische, Fische, Fische, Fische, Fische, Fische, Fische, Fische, Fische, Fische, Fische, Fische, Fische, Fische, Fische, Fische, Fische, Fische, Fische, Fische, Fische, Fische, Fische, Fische, Fische, Fische, Fische, Fische, Fische, Fische, Fische, Fische, Fische, Fische, F | Fischers Fritz fischt frische Fische, frische Fische fischt Fischers Fritz.
boost1|L | boost1 | L | s07 | -49.811 | -35.8296 | 17.9942 | 0.0183 | 0.2 | 0.04 | Die Donaudampfschifffahrtsgesellschaft prüft den Wärmepunktenwartungsvertrag. | Die Donaudampfschifffahrtsgesellschaft prüft den Wärmepumpenwartungsvertrag.
boost1|L | boost1 | L | s08 | -51.2317 | -36.4235 | 17.1523 | 0.0496 | 0.0 | 0.0 | Setze die Heizung im Arbeitszimmer auf 21,5 Grad. | Setze die Heizung im Arbeitszimmer auf einundzwanzig Komma fünf Grad.
boost1|L | boost1 | L | s09 | -50.1664 | -36.3579 | 16.936 | 0.0119 | 0.0 | 0.0 | Der Raspberry Pi überträgt die Audio-Daten per WLAN an den Server. | Der Raspberry Pi überträgt die Audiodaten per WLAN an den Server.
boost1|L | boost1 | L | s10 | -50.8107 | -37.8311 | 17.5678 | 0.0218 | 0.1 | 0.0185 | Erinnere dich morgen um 7.30 Uhr an den Müll. | Erinnere mich morgen um sieben Uhr dreißig an den Müll.
boost1|R | boost1 | R | s01 | -47.9464 | -32.927 | 20.8861 | 0.0144 | 0.0 | 0.0 | Schalte das Licht im Wohnzimmer auf 50 Prozent. | Schalte das Licht im Wohnzimmer auf fünfzig Prozent.
boost1|R | boost1 | R | s02 | -48.1638 | -32.782 | 21.3047 | 0.0172 | 0.1667 | 0.069 | Wie warm ist das im Badezimmer? | Wie warm ist es im Badezimmer?
boost1|R | boost1 | R | s03 | -47.827 | -34.6994 | 20.2131 | 0.0036 | 0.0 | 0.0 | Stelle einen Timer auf 3 Minuten. | Stelle einen Timer auf drei Minuten.
boost1|R | boost1 | R | s04 | -50.532 | -34.9181 | 18.8761 | 0.0433 | 0.1429 | 0.0208 | Die 12-jährige übt Querflute in der Grünstraße. | Die Zwölfjährige übt Querflöte in der Grünstraße.
boost1|R | boost1 | R | s05 | -48.5994 | -34.8886 | 20.0684 | 0.0071 | 0.4286 | 0.1739 | Öffne die Roller mit dem Schlafzimmer zur Hälfte. | Öffne die Rollläden im Schlafzimmer zur Hälfte.
boost1|R | boost1 | R | s06 | -49.609 | -34.1209 | 19.8176 | 0.1897 | 0.4 | 0.0274 | Fischer's Fritz fischt frische Fische, frische Fische fischt Fischer's Fritz. | Fischers Fritz fischt frische Fische, frische Fische fischt Fischers Fritz.
boost1|R | boost1 | R | s07 | -48.9248 | -35.1797 | 19.8855 | 0.0083 | 0.2 | 0.04 | Die Donaudampfschifffahrtsgesellschaft prüft den Wärmepunktenwartungsvertrag. | Die Donaudampfschifffahrtsgesellschaft prüft den Wärmepumpenwartungsvertrag.
boost1|R | boost1 | R | s08 | -50.0281 | -34.8074 | 19.3969 | 0.0229 | 0.0 | 0.0 | Setze die Heizung im Arbeitszimmer auf 21,5 Grad. | Setze die Heizung im Arbeitszimmer auf einundzwanzig Komma fünf Grad.
boost1|R | boost1 | R | s09 | -49.2902 | -36.2049 | 18.9136 | 0.0059 | 0.0 | 0.0 | Der Raspberry Pi überträgt die Audio-Daten per WLAN an den Server. | Der Raspberry Pi überträgt die Audiodaten per WLAN an den Server.
boost1|R | boost1 | R | s10 | -49.6869 | -35.8198 | 19.7407 | 0.011 | 0.0 | 0.0 | Erinnere mich morgen um 7.30 Uhr an den Müll. | Erinnere mich morgen um sieben Uhr dreißig an den Müll.
boost1|avg | boost1 | avg | s01 | -48.5592 | -33.5484 | 21.8057 | 0.0085 | 0.0 | 0.0 | Schalte das Licht im Wohnzimmer auf 50 Prozent. | Schalte das Licht im Wohnzimmer auf fünfzig Prozent.
boost1|avg | boost1 | avg | s02 | -48.9045 | -34.1678 | 22.1137 | 0.0103 | 0.1667 | 0.069 | Wie warm ist das im Badezimmer? | Wie warm ist es im Badezimmer?
boost1|avg | boost1 | avg | s03 | -48.3968 | -35.4498 | 21.1581 | 0.003 | 0.0 | 0.0 | Stelle einen Timer auf 3 Minuten. | Stelle einen Timer auf drei Minuten.
boost1|avg | boost1 | avg | s04 | -51.2113 | -36.127 | 19.7439 | 0.0241 | 0.1429 | 0.0208 | Die 12-jährige übt Querflute in der Grünstraße. | Die Zwölfjährige übt Querflöte in der Grünstraße.
boost1|avg | boost1 | avg | s05 | -49.1616 | -35.6563 | 21.0348 | 0.0043 | 0.4286 | 0.2609 | Das sind die Ruhläuten im Schlafzimmer zur Hälfte. | Öffne die Rollläden im Schlafzimmer zur Hälfte.
boost1|avg | boost1 | avg | s06 | -50.6658 | -34.9407 | 20.3183 | 0.1167 | 0.4 | 0.0274 | Fischer's Fritz fischt frische Fische, frische Fische fischt Fischer's Fritz. | Fischers Fritz fischt frische Fische, frische Fische fischt Fischers Fritz.
boost1|avg | boost1 | avg | s07 | -49.501 | -35.554 | 20.8624 | 0.0063 | 0.2 | 0.04 | Die Donaudampfschifffahrtsgesellschaft prüft den Wärmepunktenwartungsvertrag. | Die Donaudampfschifffahrtsgesellschaft prüft den Wärmepumpenwartungsvertrag.
boost1|avg | boost1 | avg | s08 | -50.8877 | -35.7063 | 20.095 | 0.0139 | 0.0 | 0.0 | Setze die Heizung im Arbeitszimmer auf 21,5 Grad. | Setze die Heizung im Arbeitszimmer auf einundzwanzig Komma fünf Grad.
boost1|avg | boost1 | avg | s09 | -49.8323 | -36.4732 | 19.8704 | 0.0045 | 0.0 | 0.0 | Der Raspberry Pi überträgt die Audio-Daten per WLAN an den Server. | Der Raspberry Pi überträgt die Audiodaten per WLAN an den Server.
boost1|avg | boost1 | avg | s10 | -50.393 | -37.7269 | 20.5791 | 0.0074 | 0.0 | 0.0 | Erinnere mich morgen um 7.30 Uhr an den Müll. | Erinnere mich morgen um sieben Uhr dreißig an den Müll.
boost1|evo4 | boost1 | evo4 | s01 | -49.1336 | -35.0835 | 24.1038 | 0.0055 | 0.0 | 0.0 | Schalte das Licht im Wohnzimmer auf 50 Prozent. | Schalte das Licht im Wohnzimmer auf fünfzig Prozent.
boost1|evo4 | boost1 | evo4 | s02 | -51.4189 | -36.8939 | 22.8544 | 0.0049 | 0.0 | 0.0 | Wie warm ist es im Badezimmer? | Wie warm ist es im Badezimmer?
boost1|evo4 | boost1 | evo4 | s03 | -48.0315 | -33.5638 | 25.0929 | 0.0008 | 0.0 | 0.0 | Stelle einen Timer auf 3 Minuten. | Stelle einen Timer auf drei Minuten.
boost1|evo4 | boost1 | evo4 | s04 | -51.1859 | -36.1384 | 23.0129 | 0.017 | 0.1429 | 0.0208 | Die 12-Jährige übt Querflute in der Grünstraße. | Die Zwölfjährige übt Querflöte in der Grünstraße.
boost1|evo4 | boost1 | evo4 | s05 | -49.8209 | -36.2281 | 23.6917 | 0.0026 | 0.1429 | 0.087 | Öffne die Roller im Schlafzimmer zur Hälfte. | Öffne die Rollläden im Schlafzimmer zur Hälfte.
boost1|evo4 | boost1 | evo4 | s06 | -51.6904 | -35.634 | 22.1158 | 0.1752 | 0.0 | 0.0 | Fischers Fritz fischt frische Fische, frische Fische fischt Fischers Fritz. | Fischers Fritz fischt frische Fische, frische Fische fischt Fischers Fritz.
boost1|evo4 | boost1 | evo4 | s07 | -50.2274 | -35.7524 | 23.3639 | 0.0038 | 0.2 | 0.0267 | Die Donaudampfschifffahrtsgesellschaft prüft den Wärmepundenwartungsvertrag. | Die Donaudampfschifffahrtsgesellschaft prüft den Wärmepumpenwartungsvertrag.
boost1|evo4 | boost1 | evo4 | s08 | -51.2787 | -34.767 | 22.9322 | 0.0052 | 0.0 | 0.0 | Setze die Heizung im Arbeitszimmer auf 21,5 Grad. | Setze die Heizung im Arbeitszimmer auf einundzwanzig Komma fünf Grad.
boost1|evo4 | boost1 | evo4 | s09 | -50.45 | -36.1241 | 22.9695 | 0.0013 | 0.0 | 0.0 | Der Raspberry Pi überträgt die Audiodaten per WLAN an den Server. | Der Raspberry Pi überträgt die Audiodaten per WLAN an den Server.
boost1|evo4 | boost1 | evo4 | s10 | -50.0344 | -35.7224 | 24.1992 | 0.0028 | 0.0 | 0.0 | Erinnere mich morgen um 7.30 Uhr an den Müll. | Erinnere mich morgen um sieben Uhr dreißig an den Müll.
boost3|L | boost3 | L | s01 | -32.875 | -18.5648 | 18.6983 | 0.0281 | 0.0 | 0.0 | Schalte das Licht im Wohnzimmer auf 50 Prozent. | Schalte das Licht im Wohnzimmer auf fünfzig Prozent.
boost3|L | boost3 | L | s02 | -33.2592 | -19.1986 | 18.949 | 0.036 | 0.0 | 0.0 | Wie warm ist es im Badezimmer? | Wie warm ist es im Badezimmer?
boost3|L | boost3 | L | s03 | -32.7353 | -20.2838 | 18.0154 | 0.0067 | 0.0 | 0.0 | Stelle einen Timer auf 3 Minuten. | Stelle einen Timer auf drei Minuten.
boost3|L | boost3 | L | s04 | -35.2398 | -20.9139 | 16.8809 | 0.0825 | 0.1429 | 0.0208 | Die 12-jährige übt Querflute in der Grünstraße. | Die Zwölfjährige übt Querflöte in der Grünstraße.
boost3|L | boost3 | L | s05 | -33.4544 | -20.2948 | 17.9315 | 0.017 | 0.4286 | 0.2391 | Das sind die Ruhlerden im Schlafzimmer zur Hälfte. | Öffne die Rollläden im Schlafzimmer zur Hälfte.
boost3|L | boost3 | L | s06 | -33.7016 | -16.6814 | 18.487 | 0.3126 | 0.4 | 0.0822 | Fischer Spritz fischt frische Fische. Frische Fische fischt Fischer Spritz. | Fischers Fritz fischt frische Fische, frische Fische fischt Fischers Fritz.
boost3|L | boost3 | L | s07 | -33.7583 | -20.2236 | 17.7934 | 0.018 | 0.2 | 0.04 | Die Donaudampfschifffahrtsgesellschaft prüft den Wärmepunktenwartungsvertrag. | Die Donaudampfschifffahrtsgesellschaft prüft den Wärmepumpenwartungsvertrag.
boost3|L | boost3 | L | s08 | -35.1383 | -19.8561 | 16.9966 | 0.0508 | 0.0 | 0.0 | Setze die Heizung im Arbeitszimmer auf 21,5 Grad. | Setze die Heizung im Arbeitszimmer auf einundzwanzig Komma fünf Grad.
boost3|L | boost3 | L | s09 | -34.0978 | -19.8015 | 16.757 | 0.0121 | 0.0 | 0.0 | Der Raspberry Pi überträgt die Audio-Daten per WLAN an den Server. | Der Raspberry Pi überträgt die Audiodaten per WLAN an den Server.
boost3|L | boost3 | L | s10 | -34.7639 | -21.3487 | 17.3684 | 0.0219 | 0.0 | 0.0 | Erinnere mich morgen um 7.30 Uhr an den Müll. | Erinnere mich morgen um sieben Uhr dreißig an den Müll.
boost3|R | boost3 | R | s01 | -32.0243 | -17.5919 | 21.0539 | 0.0145 | 0.0 | 0.0 | Schalte das Licht im Wohnzimmer auf 50%. | Schalte das Licht im Wohnzimmer auf fünfzig Prozent.
boost3|R | boost3 | R | s02 | -32.2006 | -16.3691 | 21.4998 | 0.0168 | 0.1667 | 0.069 | Wie warm ist das im Badezimmer? | Wie warm ist es im Badezimmer?
boost3|R | boost3 | R | s03 | -31.8799 | -18.8184 | 20.3894 | 0.0036 | 0.0 | 0.0 | Stelle einen Timer auf 3 Minuten. | Stelle einen Timer auf drei Minuten.
boost3|R | boost3 | R | s04 | -34.5569 | -19.1173 | 19.0509 | 0.0431 | 0.1429 | 0.0208 | Die 12-jährige übt Querflute in der Grünstraße. | Die Zwölfjährige übt Querflöte in der Grünstraße.
boost3|R | boost3 | R | s05 | -32.6399 | -19.2954 | 20.2479 | 0.008 | 0.4286 | 0.1739 | Öffne die Roller mit dem Schlafzimmer zur Hälfte. | Öffne die Rollläden im Schlafzimmer zur Hälfte.
boost3|R | boost3 | R | s06 | -33.6328 | -17.9445 | 20.0213 | 0.1918 | 0.4 | 0.0274 | Fischer's Fritz fischt frische Fische, frische Fische fischt Fischer's Fritz. | Fischers Fritz fischt frische Fische, frische Fische fischt Fischers Fritz.
boost3|R | boost3 | R | s07 | -32.9955 | -19.0046 | 20.0688 | 0.0083 | 0.2 | 0.0667 | Die Donaudampfschifffahrtsgesellschaft prüft den Werbepunktenwartungsvertrag. | Die Donaudampfschifffahrtsgesellschaft prüft den Wärmepumpenwartungsvertrag.
boost3|R | boost3 | R | s08 | -34.0523 | -19.3306 | 19.5957 | 0.0226 | 0.0 | 0.0 | Setze die Heizung im Arbeitszimmer auf 21,5 Grad. | Setze die Heizung im Arbeitszimmer auf einundzwanzig Komma fünf Grad.
boost3|R | boost3 | R | s09 | -33.308 | -19.8254 | 19.1045 | 0.0059 | 0.0 | 0.0 | Der Raspberry Pi überträgt die Audio-Daten per WLAN an den Server. | Der Raspberry Pi überträgt die Audiodaten per WLAN an den Server.
boost3|R | boost3 | R | s10 | -33.7327 | -19.6124 | 19.9113 | 0.0108 | 0.0 | 0.0 | Erinnere mich morgen um 7.30 Uhr an den Müll. | Erinnere mich morgen um sieben Uhr dreißig an den Müll.
boost3|avg | boost3 | avg | s01 | -32.5756 | -18.1073 | 21.899 | 0.0085 | 0.0 | 0.0 | Schalte das Licht im Wohnzimmer auf 50 Prozent. | Schalte das Licht im Wohnzimmer auf fünfzig Prozent.
boost3|avg | boost3 | avg | s02 | -32.9053 | -17.8432 | 22.2157 | 0.0089 | 0.0 | 0.0 | Wie warm ist es im Badezimmer? | Wie warm ist es im Badezimmer?
boost3|avg | boost3 | avg | s03 | -32.385 | -19.5277 | 21.2733 | 0.003 | 0.0 | 0.0 | Stelle einen Timer auf 3 Minuten. | Stelle einen Timer auf drei Minuten.
boost3|avg | boost3 | avg | s04 | -35.2115 | -20.3735 | 19.8382 | 0.0254 | 0.1429 | 0.0208 | Die 12-jährige übt Querflute in der Grünstraße. | Die Zwölfjährige übt Querflöte in der Grünstraße.
boost3|avg | boost3 | avg | s05 | -33.1507 | -19.85 | 21.1405 | 0.0057 | 0.4286 | 0.1739 | Öffne die Roller mit dem Schlafzimmer zur Hälfte. | Öffne die Rollläden im Schlafzimmer zur Hälfte.
boost3|avg | boost3 | avg | s06 | -34.6605 | -18.8886 | 20.4186 | 0.1174 | 0.4 | 0.0274 | Fischer's Fritz fischt frische Fische. Frische Fische fischt Fischer's Fritz. | Fischers Fritz fischt frische Fische, frische Fische fischt Fischers Fritz.
boost3|avg | boost3 | avg | s07 | -33.5065 | -19.5927 | 20.9602 | 0.0062 | 0.2 | 0.04 | Die Donaudampfschifffahrtsgesellschaft prüft den Wärmepunktenwartungsvertrag. | Die Donaudampfschifffahrtsgesellschaft prüft den Wärmepumpenwartungsvertrag.
boost3|avg | boost3 | avg | s08 | -34.8557 | -19.8677 | 20.2187 | 0.014 | 0.0 | 0.0 | Setze die Heizung im Arbeitszimmer auf 21,5 Grad. | Setze die Heizung im Arbeitszimmer auf einundzwanzig Komma fünf Grad.
boost3|avg | boost3 | avg | s09 | -33.8097 | -20.4555 | 19.9819 | 0.0047 | 0.0 | 0.0 | Der Raspberry Pi überträgt die Audio-Daten per WLAN an den Server. | Der Raspberry Pi überträgt die Audiodaten per WLAN an den Server.
boost3|avg | boost3 | avg | s10 | -34.4091 | -21.674 | 20.6687 | 0.0073 | 0.0 | 0.0 | Erinnere mich morgen um 7.30 Uhr an den Müll. | Erinnere mich morgen um sieben Uhr dreißig an den Müll.
boost3|evo4 | boost3 | evo4 | s01 | -49.1353 | -35.776 | 23.7021 | 0.0056 | 0.0 | 0.0 | Schalte das Licht im Wohnzimmer auf 50 Prozent. | Schalte das Licht im Wohnzimmer auf fünfzig Prozent.
boost3|evo4 | boost3 | evo4 | s02 | -51.3695 | -37.0224 | 22.4429 | 0.0049 | 0.0 | 0.0 | Wie warm ist es im Badezimmer? | Wie warm ist es im Badezimmer?
boost3|evo4 | boost3 | evo4 | s03 | -48.0215 | -33.2859 | 24.6884 | 0.0008 | 0.0 | 0.0 | Stelle einen Timer auf 3 Minuten. | Stelle einen Timer auf drei Minuten.
boost3|evo4 | boost3 | evo4 | s04 | -51.2233 | -37.1285 | 22.6347 | 0.0169 | 0.1429 | 0.0208 | Die 12-Jährige übt Querflute in der Grünstraße. | Die Zwölfjährige übt Querflöte in der Grünstraße.
boost3|evo4 | boost3 | evo4 | s05 | -49.5956 | -36.0411 | 23.3196 | 0.0026 | 0.1429 | 0.1304 | Öffne die Rundern im Schlafzimmer zur Hälfte. | Öffne die Rollläden im Schlafzimmer zur Hälfte.
boost3|evo4 | boost3 | evo4 | s06 | -51.8939 | -36.407 | 21.7416 | 0.1756 | 0.0 | 0.0 | Fischers Fritz fischt frische Fische, frische Fische fischt Fischers Fritz. | Fischers Fritz fischt frische Fische, frische Fische fischt Fischers Fritz.
boost3|evo4 | boost3 | evo4 | s07 | -50.2119 | -35.543 | 22.9903 | 0.0038 | 0.2 | 0.04 | Die Donaudampfschifffahrtsgesellschaft prüft den Wärmepunktenwartungsvertrag. | Die Donaudampfschifffahrtsgesellschaft prüft den Wärmepumpenwartungsvertrag.
boost3|evo4 | boost3 | evo4 | s08 | -51.3471 | -35.5652 | 22.5297 | 0.0052 | 0.0 | 0.0 | Setze die Heizung im Arbeitszimmer auf 21,5 Grad. | Setze die Heizung im Arbeitszimmer auf einundzwanzig Komma fünf Grad.
boost3|evo4 | boost3 | evo4 | s09 | -49.2726 | -35.3706 | 22.5959 | 0.0013 | 0.0 | 0.0 | Der Raspberry Pi überträgt die Audiodaten per WLAN an den Server. | Der Raspberry Pi überträgt die Audiodaten per WLAN an den Server.
boost3|evo4 | boost3 | evo4 | s10 | -50.0045 | -35.7289 | 23.7825 | 0.0028 | 0.0 | 0.0 | Erinnere mich morgen um 7.30 Uhr an den Müll. | Erinnere mich morgen um sieben Uhr dreißig an den Müll.
cap28|L | cap28 | L | s01 | -51.3551 | -37.141 | 18.4938 | 0.0281 | 0.0 | 0.0 | Schalte das Licht im Wohnzimmer auf 50 Prozent. | Schalte das Licht im Wohnzimmer auf fünfzig Prozent.
cap28|L | cap28 | L | s02 | -51.7772 | -37.5474 | 18.6924 | 0.0389 | 0.1667 | 0.069 | Wie warm ist das im Badezimmer? | Wie warm ist es im Badezimmer?
cap28|L | cap28 | L | s03 | -51.2553 | -38.1902 | 17.786 | 0.0069 | 0.3333 | 0.1143 | Stell dir einen Timer auf 3 Minuten. | Stelle einen Timer auf drei Minuten.
cap28|L | cap28 | L | s04 | -53.6952 | -39.3189 | 16.7137 | 0.0836 | 0.1429 | 0.0208 | Die 12-jährige übt Querflute in der Grünstraße. | Die Zwölfjährige übt Querflöte in der Grünstraße.
cap28|L | cap28 | L | s05 | -51.9814 | -38.8378 | 17.6805 | 0.0173 | 0.4286 | 0.2174 | Das sind die Ruhläden im Schlafzimmer zur Hälfte. | Öffne die Rollläden im Schlafzimmer zur Hälfte.
cap28|L | cap28 | L | s06 | -52.2236 | -34.8713 | 18.2503 | 0.3077 | 0.4 | 0.0822 | Fischer Spritz Fischt Frische Fische, Frische Fische Fischt Fischer Spritz. | Fischers Fritz fischt frische Fische, frische Fische fischt Fischers Fritz.
cap28|L | cap28 | L | s07 | -52.2572 | -38.6585 | 17.5545 | 0.0184 | 0.2 | 0.04 | Die Donaudampfschifffahrtsgesellschaft prüft den Wärmepunktenwartungsvertrag. | Die Donaudampfschifffahrtsgesellschaft prüft den Wärmepumpenwartungsvertrag.
cap28|L | cap28 | L | s08 | -53.6387 | -38.704 | 16.7747 | 0.05 | 0.0 | 0.0 | Setze die Heizung im Arbeitszimmer auf 21,5 Grad. | Setze die Heizung im Arbeitszimmer auf einundzwanzig Komma fünf Grad.
cap28|L | cap28 | L | s09 | -52.6253 | -39.006 | 16.5422 | 0.0127 | 0.0 | 0.0 | Der Raspberry Pi überträgt die Audio-Daten per WLAN an den Server. | Der Raspberry Pi überträgt die Audiodaten per WLAN an den Server.
cap28|L | cap28 | L | s10 | -53.2667 | -39.6643 | 17.1596 | 0.0228 | 0.0 | 0.0 | Erinnere mich morgen um 7.30 Uhr an den Müll. | Erinnere mich morgen um sieben Uhr dreißig an den Müll.
cap28|R | cap28 | R | s01 | -50.6425 | -35.7958 | 20.1672 | 0.0149 | 0.0 | 0.0 | Schalte das Licht im Wohnzimmer auf 50%. | Schalte das Licht im Wohnzimmer auf fünfzig Prozent.
cap28|R | cap28 | R | s02 | -50.8942 | -35.0659 | 20.5556 | 0.0187 | 0.1667 | 0.069 | Wie warm ist das im Badezimmer? | Wie warm ist es im Badezimmer?
cap28|R | cap28 | R | s03 | -50.5539 | -37.2004 | 19.4725 | 0.0038 | 0.0 | 0.0 | Stelle einen Timer auf 3 Minuten. | Stelle einen Timer auf drei Minuten.
cap28|R | cap28 | R | s04 | -53.1534 | -38.3047 | 18.1925 | 0.0433 | 0.1429 | 0.0208 | Die 12-jährige übt Querflute in der Grünstraße. | Die Zwölfjährige übt Querflöte in der Grünstraße.
cap28|R | cap28 | R | s05 | -51.2899 | -37.5854 | 19.3505 | 0.008 | 0.4286 | 0.1739 | Öffne die Roller mit dem Schlafzimmer zur Hälfte. | Öffne die Rollläden im Schlafzimmer zur Hälfte.
cap28|R | cap28 | R | s06 | -52.2975 | -36.3697 | 19.1156 | 0.1907 | 0.4 | 0.0274 | Fischer's Fritz fischt frische Fische, frische Fische fischt Fischer's Fritz. | Fischers Fritz fischt frische Fische, frische Fische fischt Fischers Fritz.
cap28|R | cap28 | R | s07 | -51.649 | -37.6863 | 19.1466 | 0.0086 | 0.2 | 0.04 | Die Donaudampfschifffahrtsgesellschaft prüft den Wärmepunktenwartungsvertrag. | Die Donaudampfschifffahrtsgesellschaft prüft den Wärmepumpenwartungsvertrag.
cap28|R | cap28 | R | s08 | -52.6679 | -37.9544 | 18.732 | 0.0229 | 0.0 | 0.0 | Setze die Heizung im Arbeitszimmer auf 21,5 Grad. | Setze die Heizung im Arbeitszimmer auf einundzwanzig Komma fünf Grad.
cap28|R | cap28 | R | s09 | -51.9836 | -38.7751 | 18.198 | 0.0062 | 0.0909 | 0.0312 | Der Raspberry Pi überträgt die Audio-Datum per WLAN an den Server. | Der Raspberry Pi überträgt die Audiodaten per WLAN an den Server.
cap28|R | cap28 | R | s10 | -52.3562 | -38.5032 | 19.0442 | 0.0112 | 0.1 | 0.0185 | Erinnere dich morgen um 7.30 Uhr an den Müll. | Erinnere mich morgen um sieben Uhr dreißig an den Müll.
cap28|avg | cap28 | avg | s01 | -51.1312 | -36.4424 | 21.0747 | 0.0086 | 0.0 | 0.0 | Schalte das Licht im Wohnzimmer auf 50 Prozent. | Schalte das Licht im Wohnzimmer auf fünfzig Prozent.
cap28|avg | cap28 | avg | s02 | -51.5201 | -36.2527 | 21.3362 | 0.0109 | 0.1667 | 0.069 | Wie warm ist das im Badezimmer? | Wie warm ist es im Badezimmer?
cap28|avg | cap28 | avg | s03 | -50.987 | -37.6812 | 20.4205 | 0.0031 | 0.0 | 0.0 | Stelle einen Timer auf 3 Minuten. | Stelle einen Timer auf drei Minuten.
cap28|avg | cap28 | avg | s04 | -53.756 | -39.1963 | 19.0466 | 0.0248 | 0.1429 | 0.0208 | Die 12-jährige übt Querflute in der Grünstraße. | Die Zwölfjährige übt Querflöte in der Grünstraße.
cap28|avg | cap28 | avg | s05 | -51.7443 | -38.4555 | 20.2922 | 0.006 | 0.1429 | 0.0652 | Öffne die Ruhläden im Schlafzimmer zur Hälfte. | Öffne die Rollläden im Schlafzimmer zur Hälfte.
cap28|avg | cap28 | avg | s06 | -53.2382 | -37.5482 | 19.5939 | 0.1178 | 0.4 | 0.0274 | Fischer's Fritz fischt frische Fische. Frische Fische fischt Fischer's Fritz. | Fischers Fritz fischt frische Fische, frische Fische fischt Fischers Fritz.
cap28|avg | cap28 | avg | s07 | -52.0921 | -38.2342 | 20.1002 | 0.0065 | 0.2 | 0.04 | . Die Donaudampfschifffahrtsgesellschaft prüft den Wärmepunktenwartungsvertrag. | Die Donaudampfschifffahrtsgesellschaft prüft den Wärmepumpenwartungsvertrag.
cap28|avg | cap28 | avg | s08 | -53.4268 | -38.4311 | 19.4011 | 0.0142 | 0.0 | 0.0 | Setze die Heizung im Arbeitszimmer auf 21,5 Grad. | Setze die Heizung im Arbeitszimmer auf einundzwanzig Komma fünf Grad.
cap28|avg | cap28 | avg | s09 | -52.4148 | -38.9933 | 19.1422 | 0.005 | 0.0 | 0.0 | Der Raspberry Pi überträgt die Audio-Daten per Wlan an den Server. | Der Raspberry Pi überträgt die Audiodaten per WLAN an den Server.
cap28|avg | cap28 | avg | s10 | -52.978 | -40.1101 | 19.8509 | 0.0078 | 0.0 | 0.0 | Erinnere mich morgen um 7.30 Uhr an den Müll. | Erinnere mich morgen um sieben Uhr dreißig an den Müll.
cap28|evo4 | cap28 | evo4 | s01 | -48.7776 | -35.67 | 22.8001 | 0.0056 | 0.0 | 0.0 | Schalte das Licht im Wohnzimmer auf 50%. | Schalte das Licht im Wohnzimmer auf fünfzig Prozent.
cap28|evo4 | cap28 | evo4 | s02 | -51.1013 | -36.5685 | 21.5208 | 0.0049 | 0.0 | 0.0 | Wie warm ist es im Badezimmer? | Wie warm ist es im Badezimmer?
cap28|evo4 | cap28 | evo4 | s03 | -47.9806 | -33.399 | 23.7272 | 0.0009 | 0.0 | 0.0 | Stelle einen Timer auf 3 Minuten. | Stelle einen Timer auf drei Minuten.
cap28|evo4 | cap28 | evo4 | s04 | -50.6943 | -36.4093 | 21.7086 | 0.017 | 0.1429 | 0.0208 | Die 12-Jährige übt Querflute in der Grünstraße. | Die Zwölfjährige übt Querflöte in der Grünstraße.
cap28|evo4 | cap28 | evo4 | s05 | -49.2641 | -35.6448 | 22.3504 | 0.0026 | 0.1429 | 0.087 | Öffne die Roller im Schlafzimmer zur Hälfte. | Öffne die Rollläden im Schlafzimmer zur Hälfte.
cap28|evo4 | cap28 | evo4 | s06 | -51.6057 | -36.6371 | 20.8074 | 0.1766 | 0.4 | 0.0274 | Fischer's Fritz fischt frische Fische, frische Fische fischt Fischer's Fritz. | Fischers Fritz fischt frische Fische, frische Fische fischt Fischers Fritz.
cap28|evo4 | cap28 | evo4 | s07 | -49.9909 | -35.6363 | 22.0337 | 0.0038 | 0.2 | 0.04 | Die Donaudampfschifffahrtsgesellschaft prüft den Wärmepunktenwartungsvertrag. | Die Donaudampfschifffahrtsgesellschaft prüft den Wärmepumpenwartungsvertrag.
cap28|evo4 | cap28 | evo4 | s08 | -50.7899 | -34.8896 | 21.6009 | 0.0053 | 0.0 | 0.0 | Setze die Heizung im Arbeitszimmer auf 21,5 Grad. | Setze die Heizung im Arbeitszimmer auf einundzwanzig Komma fünf Grad.
cap28|evo4 | cap28 | evo4 | s09 | -49.9744 | -35.0445 | 21.6451 | 0.0013 | 0.0 | 0.0 | Der Raspberry Pi überträgt die Audiodaten per WLAN an den Server. | Der Raspberry Pi überträgt die Audiodaten per WLAN an den Server.
cap28|evo4 | cap28 | evo4 | s10 | -49.6982 | -36.0397 | 22.8538 | 0.0028 | 0.0 | 0.0 | Erinnere mich morgen um 7.30 Uhr an den Müll. | Erinnere mich morgen um sieben Uhr dreißig an den Müll.
cap35|L | cap35 | L | s01 | -46.1569 | -31.6351 | 18.6171 | 0.0284 | 0.0 | 0.0 | Schalte das Licht im Wohnzimmer auf 50 Prozent. | Schalte das Licht im Wohnzimmer auf fünfzig Prozent.
cap35|L | cap35 | L | s02 | -46.5479 | -32.1887 | 18.8707 | 0.0377 | 0.0 | 0.0 | Wie warm ist es im Badezimmer? | Wie warm ist es im Badezimmer?
cap35|L | cap35 | L | s03 | -46.0488 | -33.3873 | 17.9327 | 0.0058 | 0.0 | 0.0 | Stelle einen Timer auf 3 Minuten. | Stelle einen Timer auf drei Minuten.
cap35|L | cap35 | L | s04 | -48.4718 | -33.9104 | 16.8539 | 0.0856 | 0.1429 | 0.0208 | Die 12-jährige übt Querflute in der Grünstraße. | Die Zwölfjährige übt Querflöte in der Grünstraße.
cap35|L | cap35 | L | s05 | -46.7223 | -33.7928 | 17.8716 | 0.0176 | 0.4286 | 0.2609 | dass mir die Ruhleiden im Schlafzimmer zur Hälfte. | Öffne die Rollläden im Schlafzimmer zur Hälfte.
cap35|L | cap35 | L | s06 | -46.9942 | -31.0199 | 18.4032 | 0.3136 | 0.4 | 0.0822 | Fischer Spritz Fischt Frische Fische, Frische Fische Fischt Fischer Spritz. | Fischers Fritz fischt frische Fische, frische Fische fischt Fischers Fritz.
cap35|L | cap35 | L | s07 | -47.0221 | -33.2788 | 17.7178 | 0.0184 | 0.4 | 0.08 | Die Donaudampfschifffahrtsgesellschaft prüft den werngepunten Wartungsvertrag. | Die Donaudampfschifffahrtsgesellschaft prüft den Wärmepumpenwartungsvertrag.
cap35|L | cap35 | L | s08 | -48.4332 | -33.1815 | 16.9157 | 0.0504 | 0.0 | 0.0 | Setze die Heizung im Arbeitszimmer auf 21,5 Grad. | Setze die Heizung im Arbeitszimmer auf einundzwanzig Komma fünf Grad.
cap35|L | cap35 | L | s09 | -47.413 | -33.5751 | 16.6654 | 0.0123 | 0.0 | 0.0 | Der Raspberry Pi überträgt die Audio-Daten per WLAN an den Server. | Der Raspberry Pi überträgt die Audiodaten per WLAN an den Server.
cap35|L | cap35 | L | s10 | -48.0471 | -34.6511 | 17.2982 | 0.0219 | 0.0 | 0.0 | Erinnere mich morgen um 7.30 Uhr an den Müll. | Erinnere mich morgen um sieben Uhr dreißig an den Müll.
cap35|R | cap35 | R | s01 | -45.4415 | -30.3989 | 20.3392 | 0.0142 | 0.0 | 0.0 | Schalte das Licht im Wohnzimmer auf 50%. | Schalte das Licht im Wohnzimmer auf fünfzig Prozent.
cap35|R | cap35 | R | s02 | -45.6596 | -30.092 | 20.7575 | 0.0175 | 0.1667 | 0.069 | Wie warm ist das im Badezimmer? | Wie warm ist es im Badezimmer?
cap35|R | cap35 | R | s03 | -45.2791 | -31.9873 | 19.7227 | 0.0032 | 0.0 | 0.0 | Stelle einen Timer auf 3 Minuten. | Stelle einen Timer auf drei Minuten.
cap35|R | cap35 | R | s04 | -47.9555 | -32.621 | 18.3849 | 0.0435 | 0.1429 | 0.0208 | Die 12-jährige übt Querflute in der Grünstraße. | Die Zwölfjährige übt Querflöte in der Grünstraße.
cap35|R | cap35 | R | s05 | -46.0359 | -32.6097 | 19.5808 | 0.008 | 0.4286 | 0.1739 | Öffne die Roller mit dem Schlafzimmer zur Hälfte. | Öffne die Rollläden im Schlafzimmer zur Hälfte.
cap35|R | cap35 | R | s06 | -47.073 | -31.3143 | 19.3061 | 0.192 | 0.4 | 0.0274 | Fischer's Fritz fischt frische Fische, frische Fische fischt Fischer's Fritz. | Fischers Fritz fischt frische Fische, frische Fische fischt Fischers Fritz.
cap35|R | cap35 | R | s07 | -46.4153 | -32.6505 | 19.383 | 0.0084 | 0.2 | 0.04 | Die Donaudampfschifffahrtsgesellschaft prüft den Wärmepunktenwartungsvertrag. | Die Donaudampfschifffahrtsgesellschaft prüft den Wärmepumpenwartungsvertrag.
cap35|R | cap35 | R | s08 | -47.4778 | -32.6278 | 18.9031 | 0.023 | 0.0 | 0.0 | Setze die Heizung im Arbeitszimmer auf 21,5 Grad. | Setze die Heizung im Arbeitszimmer auf einundzwanzig Komma fünf Grad.
cap35|R | cap35 | R | s09 | -46.7638 | -33.7449 | 18.4032 | 0.0059 | 0.0 | 0.0 | Der Raspberry Pi überträgt die Audio-Daten per WLAN an den Server. | Der Raspberry Pi überträgt die Audiodaten per WLAN an den Server.
cap35|R | cap35 | R | s10 | -47.139 | -33.7578 | 19.2529 | 0.0108 | 0.0 | 0.0 | Erinnere mich morgen um 7.30 Uhr an den Müll. | Erinnere mich morgen um sieben Uhr dreißig an den Müll.
cap35|avg | cap35 | avg | s01 | -45.9413 | -30.995 | 21.2331 | 0.0086 | 0.0 | 0.0 | Schalte das Licht im Wohnzimmer auf 50 Prozent. | Schalte das Licht im Wohnzimmer auf fünfzig Prozent.
cap35|avg | cap35 | avg | s02 | -46.2889 | -31.312 | 21.5373 | 0.0096 | 0.0 | 0.0 | Wie warm ist es im Badezimmer? | Wie warm ist es im Badezimmer?
cap35|avg | cap35 | avg | s03 | -45.7396 | -32.7105 | 20.6329 | 0.0023 | 0.0 | 0.0 | Stelle einen Timer auf 3 Minuten. | Stelle einen Timer auf drei Minuten.
cap35|avg | cap35 | avg | s04 | -48.5337 | -33.4763 | 19.2231 | 0.0258 | 0.1429 | 0.0208 | Die 12-jährige übt Querflute in der Grünstraße. | Die Zwölfjährige übt Querflöte in der Grünstraße.
cap35|avg | cap35 | avg | s05 | -46.491 | -33.4139 | 20.5096 | 0.006 | 0.0 | 0.0 | Öffne die Rollläden im Schlafzimmer zur Hälfte. | Öffne die Rollläden im Schlafzimmer zur Hälfte.
cap35|avg | cap35 | avg | s06 | -48.0235 | -32.4331 | 19.7576 | 0.1184 | 0.4 | 0.0274 | Fischer's Fritz fischt frische Fische, frische Fische fischt Fischer's Fritz. | Fischers Fritz fischt frische Fische, frische Fische fischt Fischers Fritz.
cap35|avg | cap35 | avg | s07 | -46.856 | -33.3015 | 20.3119 | 0.0063 | 0.2 | 0.04 | Die Donaudampfschifffahrtsgesellschaft prüft den Wärmepunktenwartungsvertrag. | Die Donaudampfschifffahrtsgesellschaft prüft den Wärmepumpenwartungsvertrag.
cap35|avg | cap35 | avg | s08 | -48.227 | -33.0956 | 19.5651 | 0.0142 | 0.0 | 0.0 | Setze die Heizung im Arbeitszimmer auf 21,5 Grad. | Setze die Heizung im Arbeitszimmer auf einundzwanzig Komma fünf Grad.
cap35|avg | cap35 | avg | s09 | -47.1995 | -33.7559 | 19.3197 | 0.0049 | 0.0 | 0.0 | Der Raspberry Pi überträgt die Audio-Daten per WLAN an den Server. | Der Raspberry Pi überträgt die Audiodaten per WLAN an den Server.
cap35|avg | cap35 | avg | s10 | -47.7502 | -34.9816 | 20.039 | 0.0075 | 0.0 | 0.0 | Erinnere mich morgen um 7.30 Uhr an den Müll. | Erinnere mich morgen um sieben Uhr dreißig an den Müll.
cap35|evo4 | cap35 | evo4 | s01 | -48.9212 | -34.7088 | 23.3623 | 0.0056 | 0.0 | 0.0 | Schalte das Licht im Wohnzimmer auf 50%. | Schalte das Licht im Wohnzimmer auf fünfzig Prozent.
cap35|evo4 | cap35 | evo4 | s02 | -50.9477 | -36.9455 | 22.1403 | 0.0049 | 0.0 | 0.0 | Wie warm ist es im Badezimmer? | Wie warm ist es im Badezimmer?
cap35|evo4 | cap35 | evo4 | s03 | -47.7697 | -33.0728 | 24.3336 | 0.0009 | 0.0 | 0.0 | Stelle einen Timer auf 3 Minuten. | Stelle einen Timer auf drei Minuten.
cap35|evo4 | cap35 | evo4 | s04 | -50.6525 | -36.5686 | 22.3338 | 0.017 | 0.1429 | 0.0208 | Die 12-Jährige übt Querflute in der Grünstraße. | Die Zwölfjährige übt Querflöte in der Grünstraße.
cap35|evo4 | cap35 | evo4 | s05 | -49.4739 | -36.2342 | 23.0087 | 0.0026 | 0.1429 | 0.087 | Öffne die Roller im Schlafzimmer zur Hälfte. | Öffne die Rollläden im Schlafzimmer zur Hälfte.
cap35|evo4 | cap35 | evo4 | s06 | -51.5266 | -35.9482 | 21.421 | 0.1758 | 0.4 | 0.0274 | Fischer's Fritz fischt frische Fische, frische Fische fischt Fischer's Fritz. | Fischers Fritz fischt frische Fische, frische Fische fischt Fischers Fritz.
cap35|evo4 | cap35 | evo4 | s07 | -49.8892 | -35.9166 | 22.6843 | 0.0037 | 0.2 | 0.04 | Die Donaudampfschifffahrtsgesellschaft prüft den Wärmepunktenwartungsvertrag. | Die Donaudampfschifffahrtsgesellschaft prüft den Wärmepumpenwartungsvertrag.
cap35|evo4 | cap35 | evo4 | s08 | -50.9025 | -35.2654 | 22.2152 | 0.0053 | 0.0 | 0.0 | Setze die Heizung im Arbeitszimmer auf 21,5 Grad. | Setze die Heizung im Arbeitszimmer auf einundzwanzig Komma fünf Grad.
cap35|evo4 | cap35 | evo4 | s09 | -50.0425 | -35.7771 | 22.2674 | 0.0013 | 0.0 | 0.0 | Der Raspberry Pi überträgt die Audiodaten per WLAN an den Server. | Der Raspberry Pi überträgt die Audiodaten per WLAN an den Server.
cap35|evo4 | cap35 | evo4 | s10 | -49.7564 | -36.3081 | 23.4738 | 0.0028 | 0.0 | 0.0 | Erinnere mich morgen um 7.30 Uhr an den Müll. | Erinnere mich morgen um sieben Uhr dreißig an den Müll.
cap47|L | cap47 | L | s01 | -37.1035 | -22.4432 | 18.7623 | 0.0283 | 0.0 | 0.0 | Schalte das Licht im Wohnzimmer auf 50 Prozent. | Schalte das Licht im Wohnzimmer auf fünfzig Prozent.
cap47|L | cap47 | L | s02 | -37.5123 | -23.0504 | 18.9833 | 0.0386 | 0.0 | 0.0 | Wie warm ist es im Badezimmer? | Wie warm ist es im Badezimmer?
cap47|L | cap47 | L | s03 | -37.0012 | -23.686 | 18.0287 | 0.0068 | 0.0 | 0.0 | Stelle einen Timer auf 3 Minuten. | Stelle einen Timer auf drei Minuten.
cap47|L | cap47 | L | s04 | -39.477 | -25.2586 | 16.9385 | 0.0826 | 0.1429 | 0.0208 | Die 12-jährige übt Querflute in der Grünstraße. | Die Zwölfjährige übt Querflöte in der Grünstraße.
cap47|L | cap47 | L | s05 | -37.7525 | -24.2814 | 17.9209 | 0.0174 | 0.4286 | 0.2174 | Das sind die Ruhläden im Schlafzimmer zur Hälfte. | Öffne die Rollläden im Schlafzimmer zur Hälfte.
cap47|L | cap47 | L | s06 | -37.982 | -21.5877 | 18.5026 | 0.3109 | 11.0 | 11.274 | Frische Frische Frische Frische Frische Frische Frische Frische Frische Frische Frische Frische Frische Frische Frische Frische Frische Frische Frische Frische Frische Frische Frische Frische Frische Frische Frische Frische Frische Frische Frische Frische Frische Frische Frische Frische Frische Frische Frische Frische Frische Frische Frische Frische Frische Frische Frische Frische Frische Frische Frische Frische Frische Frische Frische Frische Frische Frische Frische Frische Frische Frische Frische Frische Frische Frische Frische Frische Frische Frische Frische Frische Frische Frische Frische Frische Frische Frische Frische Frische Frische Frische Frische Frische Frische Frische Frische Frische Frische Frische Frische Frische Frische Frische Frische Frische Frische Frische Frische Frische Frische Frische Frische Frische Frische Frische Frische Frische Frische Frische Frische Fr | Fischers Fritz fischt frische Fische, frische Fische fischt Fischers Fritz.
cap47|L | cap47 | L | s07 | -38.0298 | -24.6684 | 17.8196 | 0.0185 | 0.2 | 0.04 | Die Donaudampfschifffahrtsgesellschaft prüft den Wärmepunktenwartungsvertrag. | Die Donaudampfschifffahrtsgesellschaft prüft den Wärmepumpenwartungsvertrag.
cap47|L | cap47 | L | s08 | -39.4207 | -23.892 | 17.0198 | 0.0495 | 0.0 | 0.0 | Setze die Heizung im Arbeitszimmer auf 21,5 Grad. | Setze die Heizung im Arbeitszimmer auf einundzwanzig Komma fünf Grad.
cap47|L | cap47 | L | s09 | -38.3963 | -25.1153 | 16.7657 | 0.0104 | 0.0 | 0.0 | Der Raspberry Pi überträgt die Audio-Daten per WLAN an den Server. | Der Raspberry Pi überträgt die Audiodaten per WLAN an den Server.
cap47|L | cap47 | L | s10 | -38.9681 | -25.4999 | 17.4072 | 0.0212 | 0.0 | 0.0 | Erinnere mich morgen um 7.30 Uhr an den Müll. | Erinnere mich morgen um sieben Uhr dreißig an den Müll.
cap47|R | cap47 | R | s01 | -36.3711 | -21.2741 | 20.739 | 0.0146 | 0.0 | 0.0 | Schalte das Licht im Wohnzimmer auf 50%. | Schalte das Licht im Wohnzimmer auf fünfzig Prozent.
cap47|R | cap47 | R | s02 | -36.6253 | -20.5007 | 21.1197 | 0.0182 | 0.0 | 0.0 | Wie warm ist es im Badezimmer? | Wie warm ist es im Badezimmer?
cap47|R | cap47 | R | s03 | -36.2468 | -22.7583 | 20.0735 | 0.0036 | 0.0 | 0.0 | Stelle einen Timer auf 3 Minuten. | Stelle einen Timer auf drei Minuten.
cap47|R | cap47 | R | s04 | -38.9672 | -23.8511 | 18.7192 | 0.0434 | 0.1429 | 0.0208 | Die 12-jährige übt Querflute in der Grünstraße. | Die Zwölfjährige übt Querflöte in der Grünstraße.
cap47|R | cap47 | R | s05 | -37.0501 | -23.9175 | 19.8962 | 0.0079 | 0.4286 | 0.1739 | Öffne die Roller mit dem Schlafzimmer zur Hälfte. | Öffne die Rollläden im Schlafzimmer zur Hälfte.
cap47|R | cap47 | R | s06 | -38.0259 | -21.9107 | 19.6879 | 0.1896 | 0.4 | 0.0274 | Fischer's Fritz fischt frische Fische. Frische Fische fischt Fischer's Fritz. | Fischers Fritz fischt frische Fische, frische Fische fischt Fischers Fritz.
cap47|R | cap47 | R | s07 | -37.4006 | -23.0415 | 19.7111 | 0.0084 | 0.2 | 0.04 | Die Donaudampfschifffahrtsgesellschaft prüft den Wärmepunktenwartungsvertrag. | Die Donaudampfschifffahrtsgesellschaft prüft den Wärmepumpenwartungsvertrag.
cap47|R | cap47 | R | s08 | -38.4563 | -23.5608 | 19.2584 | 0.0226 | 0.0 | 0.0 | Setze die Heizung im Arbeitszimmer auf 21,5 Grad. | Setze die Heizung im Arbeitszimmer auf einundzwanzig Komma fünf Grad.
cap47|R | cap47 | R | s09 | -37.7628 | -24.7786 | 18.7264 | 0.0053 | 0.0 | 0.0 | Der Raspberry Pi überträgt die Audio-Daten per WLAN an den Server. | Der Raspberry Pi überträgt die Audiodaten per WLAN an den Server.
cap47|R | cap47 | R | s10 | -38.0464 | -24.1537 | 19.6037 | 0.0106 | 0.0 | 0.0 | Erinnere mich morgen um 7.30 Uhr an den Müll. | Erinnere mich morgen um sieben Uhr dreißig an den Müll.
cap47|avg | cap47 | avg | s01 | -36.8693 | -21.839 | 21.5738 | 0.0085 | 0.0 | 0.0 | Schalte das Licht im Wohnzimmer auf 50 Prozent. | Schalte das Licht im Wohnzimmer auf fünfzig Prozent.
cap47|avg | cap47 | avg | s02 | -37.2494 | -21.8919 | 21.8426 | 0.0105 | 0.0 | 0.0 | Wie warm ist es im Badezimmer? | Wie warm ist es im Badezimmer?
cap47|avg | cap47 | avg | s03 | -36.703 | -23.2194 | 20.9237 | 0.0031 | 0.0 | 0.0 | Stelle einen Timer auf 3 Minuten. | Stelle einen Timer auf drei Minuten.
cap47|avg | cap47 | avg | s04 | -39.5333 | -24.9214 | 19.4999 | 0.0248 | 0.1429 | 0.0208 | Die 12-jährige übt Querflute in der Grünstraße. | Die Zwölfjährige übt Querflöte in der Grünstraße.
cap47|avg | cap47 | avg | s05 | -37.5046 | -24.1316 | 20.7631 | 0.006 | 0.1429 | 0.0652 | Öffne die Ruhläden im Schlafzimmer zur Hälfte. | Öffne die Rollläden im Schlafzimmer zur Hälfte.
cap47|avg | cap47 | avg | s06 | -38.97 | -23.0046 | 20.0846 | 0.1195 | 0.4 | 0.0274 | Fischer's Fritz fischt frische Fische, frische Fische fischt Fischer's Fritz. | Fischers Fritz fischt frische Fische, frische Fische fischt Fischers Fritz.
cap47|avg | cap47 | avg | s07 | -37.8487 | -23.96 | 20.5924 | 0.0063 | 0.2 | 0.04 | Die Donaudampfschifffahrtsgesellschaft prüft den Wärmepunktenwartungsvertrag. | Die Donaudampfschifffahrtsgesellschaft prüft den Wärmepumpenwartungsvertrag.
cap47|avg | cap47 | avg | s08 | -39.1964 | -23.7779 | 19.865 | 0.014 | 0.0 | 0.0 | Setze die Heizung im Arbeitszimmer auf 21,5 Grad. | Setze die Heizung im Arbeitszimmer auf einundzwanzig Komma fünf Grad.
cap47|avg | cap47 | avg | s09 | -38.1864 | -25.1509 | 19.5958 | 0.0036 | 0.0 | 0.0 | Der Raspberry Pi überträgt die Audio-Daten per WLAN an den Server. | Der Raspberry Pi überträgt die Audiodaten per WLAN an den Server.
cap47|avg | cap47 | avg | s10 | -38.6596 | -25.9124 | 20.3347 | 0.0069 | 0.0 | 0.0 | Erinnere mich morgen um 7.30 Uhr an den Müll. | Erinnere mich morgen um sieben Uhr dreißig an den Müll.
cap47|evo4 | cap47 | evo4 | s01 | -48.9789 | -36.1921 | 23.505 | 0.0056 | 0.0 | 0.0 | Schalte das Licht im Wohnzimmer auf 50%. | Schalte das Licht im Wohnzimmer auf fünfzig Prozent.
cap47|evo4 | cap47 | evo4 | s02 | -50.4482 | -36.8189 | 22.2615 | 0.0048 | 0.0 | 0.0 | Wie warm ist es im Badezimmer? | Wie warm ist es im Badezimmer?
cap47|evo4 | cap47 | evo4 | s03 | -48.0345 | -33.4267 | 24.4635 | 0.0009 | 0.0 | 0.0 | Stelle einen Timer auf 3 Minuten. | Stelle einen Timer auf drei Minuten.
cap47|evo4 | cap47 | evo4 | s04 | -50.7063 | -37.37 | 22.4307 | 0.017 | 0.1429 | 0.0208 | Die 12-Jährige übt Querflute in der Grünstraße. | Die Zwölfjährige übt Querflöte in der Grünstraße.
cap47|evo4 | cap47 | evo4 | s05 | -49.6352 | -36.3307 | 23.0911 | 0.0026 | 0.1429 | 0.087 | Öffne die Roller im Schlafzimmer zur Hälfte. | Öffne die Rollläden im Schlafzimmer zur Hälfte.
cap47|evo4 | cap47 | evo4 | s06 | -51.8324 | -36.1766 | 21.5275 | 0.1758 | 0.4 | 0.0274 | Fischer's Fritz fischt frische Fische, frische Fische fischt Fischer's Fritz. | Fischers Fritz fischt frische Fische, frische Fische fischt Fischers Fritz.
cap47|evo4 | cap47 | evo4 | s07 | -50.0613 | -35.7265 | 22.7601 | 0.0038 | 0.2 | 0.04 | Die Donaudampfschifffahrtsgesellschaft prüft den Wärmepunktenwartungsvertrag. | Die Donaudampfschifffahrtsgesellschaft prüft den Wärmepumpenwartungsvertrag.
cap47|evo4 | cap47 | evo4 | s08 | -51.2547 | -35.0289 | 22.3184 | 0.0053 | 0.0 | 0.0 | Setze die Heizung im Arbeitszimmer auf 21,5 Grad. | Setze die Heizung im Arbeitszimmer auf einundzwanzig Komma fünf Grad.
cap47|evo4 | cap47 | evo4 | s09 | -50.0352 | -36.0596 | 22.361 | 0.0013 | 0.0 | 0.0 | Der Raspberry Pi überträgt die Audiodaten per WLAN an den Server. | Der Raspberry Pi überträgt die Audiodaten per WLAN an den Server.
cap47|evo4 | cap47 | evo4 | s10 | -47.4447 | -34.5651 | 23.5802 | 0.0028 | 0.0 | 0.0 | Erinnere mich morgen um 7.30 Uhr an den Müll. | Erinnere mich morgen um sieben Uhr dreißig an den Müll.
cap47b3|L | cap47b3 | L | s01 | -28.353 | -14.4468 | 18.7344 | 0.0269 | 0.0 | 0.0 | Schalte das Licht im Wohnzimmer auf 50 Prozent. | Schalte das Licht im Wohnzimmer auf fünfzig Prozent.
cap47b3|L | cap47b3 | L | s02 | -28.7394 | -14.2991 | 19.0327 | 0.036 | 0.0 | 0.0 | Wie warm ist es im Badezimmer? | Wie warm ist es im Badezimmer?
cap47b3|L | cap47b3 | L | s03 | -28.2691 | -15.2079 | 18.051 | 0.0058 | 0.0 | 0.0 | Stelle einen Timer auf 3 Minuten. | Stelle einen Timer auf drei Minuten.
cap47b3|L | cap47b3 | L | s04 | -30.7248 | -16.4322 | 16.941 | 0.0829 | 0.1429 | 0.0208 | Die 12-jährige übt Querflute in der Grünstraße. | Die Zwölfjährige übt Querflöte in der Grünstraße.
cap47b3|L | cap47b3 | L | s05 | -28.8665 | -15.6768 | 17.9545 | 0.0163 | 0.7143 | 0.4348 | Das sind die 100 mit dem Schlafzimmer zur Hälfte. | Öffne die Rollläden im Schlafzimmer zur Hälfte.
cap47b3|L | cap47b3 | L | s06 | -29.1823 | -13.4161 | 18.5261 | 0.3108 | 0.4 | 0.0274 | Fischer's Fritz fischt frische Fische. Frische Fische fischt Fischer's Fritz. | Fischers Fritz fischt frische Fische, frische Fische fischt Fischers Fritz.
cap47b3|L | cap47b3 | L | s07 | -29.2491 | -15.8337 | 17.8555 | 0.0171 | 0.2 | 0.04 | Die Donaudampfschifffahrtsgesellschaft prüft den Wärmepunktenwartungsvertrag. | Die Donaudampfschifffahrtsgesellschaft prüft den Wärmepumpenwartungsvertrag.
cap47b3|L | cap47b3 | L | s08 | -30.6319 | -15.4934 | 17.0283 | 0.0481 | 0.0 | 0.0 | Setze die Heizung im Arbeitszimmer auf 21,5 Grad. | Setze die Heizung im Arbeitszimmer auf einundzwanzig Komma fünf Grad.
cap47b3|L | cap47b3 | L | s09 | -27.5362 | -10.1914 | 16.8168 | 0.01 | 0.0 | 0.0 | Der Raspberry Pi überträgt die Audio-Daten per WLAN an den Server. | Der Raspberry Pi überträgt die Audiodaten per WLAN an den Server.
cap47b3|L | cap47b3 | L | s10 | -30.2707 | -16.7765 | 17.4434 | 0.0207 | 0.0 | 0.0 | Erinnere mich morgen um 7.30 Uhr an den Müll. | Erinnere mich morgen um sieben Uhr dreißig an den Müll.
cap47b3|R | cap47b3 | R | s01 | -27.4995 | -13.0504 | 20.9042 | 0.0136 | 0.0 | 0.0 | Schalte das Licht im Wohnzimmer auf 50%. | Schalte das Licht im Wohnzimmer auf fünfzig Prozent.
cap47b3|R | cap47b3 | R | s02 | -27.7391 | -11.9719 | 21.3479 | 0.0172 | 0.0 | 0.0 | Wie warm ist es im Badezimmer? | Wie warm ist es im Badezimmer?
cap47b3|R | cap47b3 | R | s03 | -27.4089 | -14.0405 | 20.2502 | 0.0033 | 0.0 | 0.0 | Stelle einen Timer auf 3 Minuten. | Stelle einen Timer auf drei Minuten.
cap47b3|R | cap47b3 | R | s04 | -30.0749 | -14.6172 | 18.9199 | 0.0421 | 0.1429 | 0.0208 | Die 12-Jährige übt Querflute in der Grünstraße. | Die Zwölfjährige übt Querflöte in der Grünstraße.
cap47b3|R | cap47b3 | R | s05 | -28.0478 | -14.5363 | 20.1301 | 0.0074 | 0.4286 | 0.1739 | Öffne die Roller mit dem Schlafzimmer zur Hälfte. | Öffne die Rollläden im Schlafzimmer zur Hälfte.
cap47b3|R | cap47b3 | R | s06 | -29.1455 | -13.3756 | 19.8522 | 0.1876 | 0.4 | 0.0274 | Fischer's Fritz fischt frische Fische, frische Fische fischt Fischer's Fritz. | Fischers Fritz fischt frische Fische, frische Fische fischt Fischers Fritz.
cap47b3|R | cap47b3 | R | s07 | -28.5045 | -14.9268 | 19.9362 | 0.008 | 0.2 | 0.0667 | Die Donaudampfschifffahrtsgesellschaft prüft den Werbepunktenwartungsvertrag. | Die Donaudampfschifffahrtsgesellschaft prüft den Wärmepumpenwartungsvertrag.
cap47b3|R | cap47b3 | R | s08 | -29.5171 | -14.8558 | 19.4851 | 0.022 | 0.0 | 0.0 | Setze die Heizung im Arbeitszimmer auf 21,5 Grad. | Setze die Heizung im Arbeitszimmer auf einundzwanzig Komma fünf Grad.
cap47b3|R | cap47b3 | R | s09 | -26.8873 | -9.4295 | 18.9768 | 0.0051 | 0.0 | 0.0 | Der Raspberry Pi überträgt die Audio-Daten per WLAN an den Server. | Der Raspberry Pi überträgt die Audiodaten per WLAN an den Server.
cap47b3|R | cap47b3 | R | s10 | -29.197 | -15.852 | 19.8318 | 0.0102 | 0.0 | 0.0 | Erinnere mich morgen um 7.30 Uhr an den Müll. | Erinnere mich morgen um sieben Uhr dreißig an den Müll.
cap47b3|avg | cap47b3 | avg | s01 | -28.0542 | -13.7998 | 21.8368 | 0.0076 | 0.0 | 0.0 | Schalte das Licht im Wohnzimmer auf 50%. | Schalte das Licht im Wohnzimmer auf fünfzig Prozent.
cap47b3|avg | cap47b3 | avg | s02 | -28.4058 | -13.3201 | 22.1818 | 0.0098 | 0.0 | 0.0 | Wie warm ist es im Badezimmer? | Wie warm ist es im Badezimmer?
cap47b3|avg | cap47b3 | avg | s03 | -27.9083 | -14.6046 | 21.2172 | 0.0025 | 0.0 | 0.0 | Stelle einen Timer auf 3 Minuten. | Stelle einen Timer auf drei Minuten.
cap47b3|avg | cap47b3 | avg | s04 | -30.705 | -15.9291 | 19.7998 | 0.0248 | 0.1429 | 0.0208 | Die 12-jährige übt Querflute in der Grünstraße. | Die Zwölfjährige übt Querflöte in der Grünstraße.
cap47b3|avg | cap47b3 | avg | s05 | -28.5606 | -15.1301 | 21.0914 | 0.0053 | 0.4286 | 0.1739 | Öffne die Roller mit dem Schlafzimmer zur Hälfte. | Öffne die Rollläden im Schlafzimmer zur Hälfte.
cap47b3|avg | cap47b3 | avg | s06 | -30.121 | -14.1867 | 20.3725 | 0.1163 | 0.4 | 0.0274 | Fischer's Fritz fischt frische Fische, frische Fische fischt Fischer's Fritz. | Fischers Fritz fischt frische Fische, frische Fische fischt Fischers Fritz.
cap47b3|avg | cap47b3 | avg | s07 | -29.0007 | -15.5802 | 20.9194 | 0.0056 | 0.2 | 0.04 | Die Donaudampfschifffahrtsgesellschaft prüft den Wärmepunktenwartungsvertrag. | Die Donaudampfschifffahrtsgesellschaft prüft den Wärmepumpenwartungsvertrag.
cap47b3|avg | cap47b3 | avg | s08 | -30.3223 | -15.1688 | 20.1807 | 0.0131 | 0.0 | 0.0 | Setze die Heizung im Arbeitszimmer auf 21,5 Grad. | Setze die Heizung im Arbeitszimmer auf einundzwanzig Komma fünf Grad.
cap47b3|avg | cap47b3 | avg | s09 | -27.2765 | -9.8964 | 19.9396 | 0.0037 | 0.0 | 0.0 | Der Raspberry Pi überträgt die Audio-Daten per WLAN an den Server. | Der Raspberry Pi überträgt die Audiodaten per WLAN an den Server.
cap47b3|avg | cap47b3 | avg | s10 | -29.8785 | -16.8238 | 20.6641 | 0.0066 | 0.0 | 0.0 | Erinnere mich morgen um 7.30 Uhr an den Müll. | Erinnere mich morgen um sieben Uhr dreißig an den Müll.
cap47b3|evo4 | cap47b3 | evo4 | s01 | -47.4646 | -34.5527 | 24.4833 | 0.0058 | 0.0 | 0.0 | Schalte das Licht im Wohnzimmer auf 50%. | Schalte das Licht im Wohnzimmer auf fünfzig Prozent.
cap47b3|evo4 | cap47b3 | evo4 | s02 | -50.9491 | -36.3672 | 23.2307 | 0.0049 | 0.0 | 0.0 | Wie warm ist es im Badezimmer? | Wie warm ist es im Badezimmer?
cap47b3|evo4 | cap47b3 | evo4 | s03 | -47.8287 | -32.9143 | 25.4593 | 0.0009 | 0.0 | 0.0 | Stelle einen Timer auf 3 Minuten. | Stelle einen Timer auf drei Minuten.
cap47b3|evo4 | cap47b3 | evo4 | s04 | -49.6647 | -36.3361 | 23.4217 | 0.0173 | 0.1429 | 0.0208 | Die 12-Jährige übt Querflute in der Grünstraße. | Die Zwölfjährige übt Querflöte in der Grünstraße.
cap47b3|evo4 | cap47b3 | evo4 | s05 | -47.4697 | -35.7189 | 24.0791 | 0.0026 | 0.1429 | 0.1304 | Öffne die Rundern im Schlafzimmer zur Hälfte. | Öffne die Rollläden im Schlafzimmer zur Hälfte.
cap47b3|evo4 | cap47b3 | evo4 | s06 | -47.3415 | -31.9271 | 22.5088 | 0.1751 | 0.4 | 0.0274 | Fischer's Fritz fischt frische Fische, frische Fische fischt Fischer's Fritz. | Fischers Fritz fischt frische Fische, frische Fische fischt Fischers Fritz.
cap47b3|evo4 | cap47b3 | evo4 | s07 | -48.2992 | -35.2221 | 23.7648 | 0.0038 | 0.2 | 0.04 | Die Donaudampfschifffahrtsgesellschaft prüft den Wärmepunktenwartungsvertrag. | Die Donaudampfschifffahrtsgesellschaft prüft den Wärmepumpenwartungsvertrag.
cap47b3|evo4 | cap47b3 | evo4 | s08 | -50.0202 | -34.7914 | 23.2969 | 0.0053 | 0.0 | 0.0 | Setze die Heizung im Arbeitszimmer auf 21,5 Grad. | Setze die Heizung im Arbeitszimmer auf einundzwanzig Komma fünf Grad.
cap47b3|evo4 | cap47b3 | evo4 | s09 | -49.7306 | -35.134 | 23.3903 | 0.0014 | 0.0 | 0.0 | Der Raspberry Pi überträgt die Audiodaten per WLAN an den Server. | Der Raspberry Pi überträgt die Audiodaten per WLAN an den Server.
cap47b3|evo4 | cap47b3 | evo4 | s10 | -49.9716 | -35.6219 | 24.5719 | 0.0028 | 0.0 | 0.0 | Erinnere mich morgen um 7.30 Uhr an den Müll. | Erinnere mich morgen um sieben Uhr dreißig an den Müll.
cap47b3_b|L | cap47b3_b | L | s01 | -28.3545 | -14.2863 | 19.1704 | 0.0266 | 0.0 | 0.0 | Schalte das Licht im Wohnzimmer auf 50 Prozent. | Schalte das Licht im Wohnzimmer auf fünfzig Prozent.
cap47b3_b|L | cap47b3_b | L | s02 | -28.7023 | -14.4457 | 19.4493 | 0.0375 | 0.0 | 0.0 | Wie warm ist es im Badezimmer? | Wie warm ist es im Badezimmer?
cap47b3_b|L | cap47b3_b | L | s03 | -28.267 | -15.0555 | 18.4313 | 0.0047 | 0.0 | 0.0 | Stelle einen Timer auf 3 Minuten. | Stelle einen Timer auf drei Minuten.
cap47b3_b|L | cap47b3_b | L | s04 | -30.7493 | -16.219 | 17.3424 | 0.0817 | 0.1429 | 0.0208 | Die 12-jährige übt Querflute in der Grünstraße. | Die Zwölfjährige übt Querflöte in der Grünstraße.
cap47b3_b|L | cap47b3_b | L | s05 | -28.9438 | -16.0983 | 18.3809 | 0.0162 | 0.4286 | 0.2826 | dass mir die Ruhläuten im Schlafzimmer zur Hälfte. | Öffne die Rollläden im Schlafzimmer zur Hälfte.
cap47b3_b|L | cap47b3_b | L | s06 | -29.2261 | -12.2471 | 18.9161 | 0.3103 | 0.4 | 0.0274 | Fischer's Fritz fischt frische Fische. Frische Fische fischt Fischer's Fritz. | Fischers Fritz fischt frische Fische, frische Fische fischt Fischers Fritz.
cap47b3_b|L | cap47b3_b | L | s07 | -29.2982 | -15.8119 | 18.2173 | 0.0171 | 0.2 | 0.04 | Die Donaudampfschifffahrtsgesellschaft prüft den Wärmepunktenwartungsvertrag. | Die Donaudampfschifffahrtsgesellschaft prüft den Wärmepumpenwartungsvertrag.
cap47b3_b|L | cap47b3_b | L | s08 | -30.6974 | -15.4355 | 17.4082 | 0.0487 | 0.0 | 0.0 | Setze die Heizung im Arbeitszimmer auf 21,5 Grad. | Setze die Heizung im Arbeitszimmer auf einundzwanzig Komma fünf Grad.
cap47b3_b|L | cap47b3_b | L | s09 | -29.6247 | -16.0727 | 17.1951 | 0.011 | 0.0 | 0.0 | Der Raspberry Pi überträgt die Audio-Daten per WLAN an den Server. | Der Raspberry Pi überträgt die Audiodaten per WLAN an den Server.
cap47b3_b|L | cap47b3_b | L | s10 | -30.2883 | -16.9713 | 17.8181 | 0.0206 | 0.0 | 0.0 | Erinnere mich morgen um 7.30 Uhr an den Müll. | Erinnere mich morgen um sieben Uhr dreißig an den Müll.
cap47b3_b|R | cap47b3_b | R | s01 | -27.5032 | -12.9284 | 20.8289 | 0.014 | 0.0 | 0.0 | Schalte das Licht im Wohnzimmer auf 50%. | Schalte das Licht im Wohnzimmer auf fünfzig Prozent.
cap47b3_b|R | cap47b3_b | R | s02 | -27.6903 | -11.6368 | 21.2795 | 0.0169 | 0.1667 | 0.069 | Wie warm ist das im Badezimmer? | Wie warm ist es im Badezimmer?
cap47b3_b|R | cap47b3_b | R | s03 | -27.4246 | -13.8324 | 20.1238 | 0.0029 | 0.0 | 0.0 | Stelle einen Timer auf 3 Minuten. | Stelle einen Timer auf drei Minuten.
cap47b3_b|R | cap47b3_b | R | s04 | -30.0912 | -14.5833 | 18.8027 | 0.0426 | 0.1429 | 0.0208 | Die 12-jährige übt Querflute in der Grünstraße. | Die Zwölfjährige übt Querflöte in der Grünstraße.
cap47b3_b|R | cap47b3_b | R | s05 | -28.1665 | -14.7569 | 20.0052 | 0.0076 | 0.4286 | 0.1739 | Öffne die Roller mit dem Schlafzimmer zur Hälfte. | Öffne die Rollläden im Schlafzimmer zur Hälfte.
cap47b3_b|R | cap47b3_b | R | s06 | -29.16 | -13.11 | 19.7688 | 0.191 | 0.4 | 0.0274 | Fischer's Fritz fischt frische Fische. Frische Fische fischt Fischer's Fritz. | Fischers Fritz fischt frische Fische, frische Fische fischt Fischers Fritz.
cap47b3_b|R | cap47b3_b | R | s07 | -28.5222 | -14.7148 | 19.8076 | 0.008 | 0.2 | 0.0667 | Die Donaudampfschifffahrtsgesellschaft prüft den Werbepunktenwartungsvertrag. | Die Donaudampfschifffahrtsgesellschaft prüft den Wärmepumpenwartungsvertrag.
cap47b3_b|R | cap47b3_b | R | s08 | -29.5814 | -14.6847 | 19.349 | 0.0222 | 0.0 | 0.0 | Setze die Heizung im Arbeitszimmer auf 21,5 Grad. | Setze die Heizung im Arbeitszimmer auf einundzwanzig Komma fünf Grad.
cap47b3_b|R | cap47b3_b | R | s09 | -28.8385 | -15.3928 | 18.8574 | 0.0055 | 0.0 | 0.0 | Der Raspberry Pi überträgt die Audio-Daten per WLAN an den Server. | Der Raspberry Pi überträgt die Audiodaten per WLAN an den Server.
cap47b3_b|R | cap47b3_b | R | s10 | -29.2339 | -15.4475 | 19.689 | 0.0102 | 0.0 | 0.0 | Erinnere mich morgen um 7.30 Uhr an den Müll. | Erinnere mich morgen um sieben Uhr dreißig an den Müll.
cap47b3_b|avg | cap47b3_b | avg | s01 | -28.0535 | -13.5808 | 21.8747 | 0.0079 | 0.0 | 0.0 | Schalte das Licht im Wohnzimmer auf 50%. | Schalte das Licht im Wohnzimmer auf fünfzig Prozent.
cap47b3_b|avg | cap47b3_b | avg | s02 | -28.3698 | -13.1206 | 22.2094 | 0.0098 | 0.1667 | 0.069 | Wie warm ist das im Badezimmer? | Wie warm ist es im Badezimmer?
cap47b3_b|avg | cap47b3_b | avg | s03 | -27.9245 | -14.4287 | 21.1993 | 0.0017 | 0.0 | 0.0 | Stelle einen Timer auf 3 Minuten. | Stelle einen Timer auf drei Minuten.
cap47b3_b|avg | cap47b3_b | avg | s04 | -30.7313 | -15.9022 | 19.7903 | 0.0233 | 0.1429 | 0.0208 | Die 12-jährige übt Querflute in der Grünstraße. | Die Zwölfjährige übt Querflöte in der Grünstraße.
cap47b3_b|avg | cap47b3_b | avg | s05 | -28.6582 | -15.4574 | 21.0971 | 0.0053 | 0.1429 | 0.0652 | Öffne die Ruhläden im Schlafzimmer zur Hälfte. | Öffne die Rollläden im Schlafzimmer zur Hälfte.
cap47b3_b|avg | cap47b3_b | avg | s06 | -30.1602 | -14.1938 | 20.3812 | 0.1185 | 0.4 | 0.0274 | Fischer's Fritz fischt frische Fische, frische Fische fischt Fischer's Fritz. | Fischers Fritz fischt frische Fische, frische Fische fischt Fischers Fritz.
cap47b3_b|avg | cap47b3_b | avg | s07 | -29.0393 | -15.4831 | 20.8924 | 0.0056 | 0.2 | 0.04 | Die Donaudampfschifffahrtsgesellschaft prüft den Wärmepunktenwartungsvertrag. | Die Donaudampfschifffahrtsgesellschaft prüft den Wärmepumpenwartungsvertrag.
cap47b3_b|avg | cap47b3_b | avg | s08 | -30.3935 | -15.2139 | 20.1544 | 0.0133 | 0.0 | 0.0 | Setze die Heizung im Arbeitszimmer auf 21,5 Grad. | Setze die Heizung im Arbeitszimmer auf einundzwanzig Komma fünf Grad.
cap47b3_b|avg | cap47b3_b | avg | s09 | -29.3321 | -16.0162 | 19.9288 | 0.004 | 0.0 | 0.0 | Der Raspberry Pi überträgt die Audio-Daten per WLAN an den Server. | Der Raspberry Pi überträgt die Audiodaten per WLAN an den Server.
cap47b3_b|avg | cap47b3_b | avg | s10 | -29.9097 | -17.1723 | 20.6355 | 0.0066 | 0.0 | 0.0 | Erinnere mich morgen um 7.30 Uhr an den Müll. | Erinnere mich morgen um sieben Uhr dreißig an den Müll.
cap47b3_b|evo4 | cap47b3_b | evo4 | s01 | -49.1165 | -35.0783 | 23.7427 | 0.0055 | 0.0 | 0.0 | Schalte das Licht im Wohnzimmer auf 50 Prozent. | Schalte das Licht im Wohnzimmer auf fünfzig Prozent.
cap47b3_b|evo4 | cap47b3_b | evo4 | s02 | -50.7676 | -36.1605 | 22.4927 | 0.0049 | 0.0 | 0.0 | Wie warm ist es im Badezimmer? | Wie warm ist es im Badezimmer?
cap47b3_b|evo4 | cap47b3_b | evo4 | s03 | -48.0732 | -33.3396 | 24.7109 | 0.0008 | 0.0 | 0.0 | Stelle einen Timer auf 3 Minuten. | Stelle einen Timer auf drei Minuten.
cap47b3_b|evo4 | cap47b3_b | evo4 | s04 | -51.0608 | -36.6744 | 22.6722 | 0.0166 | 0.1429 | 0.0208 | Die 12-Jährige übt Querflute in der Grünstraße. | Die Zwölfjährige übt Querflöte in der Grünstraße.
cap47b3_b|evo4 | cap47b3_b | evo4 | s05 | -49.6357 | -35.8833 | 23.3306 | 0.0026 | 0.1429 | 0.1304 | Öffne die Rundern im Schlafzimmer zur Hälfte. | Öffne die Rollläden im Schlafzimmer zur Hälfte.
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
