Sciddie/voice-satelite/mic-benchmark/summary_by_config.csv

config | label | channel | repeats | runs | wer_medium | cer_medium | sent_exact_medium | wer_small | cer_small | sent_exact_small | wer_medium_per_repeat | speech_rms_dbfs | peak_dbfs | clip_samples | noise_floor_dbfs | snr_db | hf_ratio_pct
alc_on | ALC an (Stereo, Default-Parameter) | L | 3 | alc_on alc_on_b alc_on_c | 0.1292 | 0.0424 | 18/30 | 0.2625 | 0.105 | 4/10 | 13.8 13.8 11.2 | -26.2689 | -8.9126 | 0 | -44.9088 | 17.8866 | 5.7968
alc_on | ALC an (Stereo, Default-Parameter) | R | 3 | alc_on alc_on_b alc_on_c | 0.0958 | 0.027 | 17/30 | 0.175 | 0.0589 | 3/10 | 10.0 8.8 10.0 | -25.626 | -8.7186 | 0 | -46.2225 | 19.9046 | 3.2205
alc_on | ALC an (Stereo, Default-Parameter) | avg | 3 | alc_on alc_on_b alc_on_c | 0.0625 | 0.0166 | 19/30 | 0.1375 | 0.0442 | 3/10 | 6.2 2.5 10.0 | -26.1644 | -10.1539 | 0 | -47.563 | 20.6788 | 1.9885
alc_on | ALC an (Stereo, Default-Parameter) | evo4 | 3 | alc_on alc_on_b alc_on_c | 0.0708 | 0.0166 | 19/30 | 0.0875 | 0.0276 | 4/10 | 8.8 3.8 8.8 | -50.0504 | -33.031 | 0 | -74.2472 | 23.2485 | 2.1972
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
